5shekel/diffpair/design/references/VL813_GoodYuHuang_schematic.txt

PAGE 1
1
1
2
2
3
3
4
4
5
5
6
6
7
7
8
8
D
D
C
C
B
B
A
A
Title
Number
Revision
Size
A3
Date:
2023/8/27
Sheet            of
File:
C:\Users\..\USB_HUB_VL813.SchDoc
Drawn By:
VBUS
1
D-
2
D+
3
GND
4
Stda_SSRX-
5
Stda_SSRX+
6
GND_DRAIN
7
Stda_SSTX-
8
Stda_SSTX+
9
GND
10
GND
11
J2
TYPE-A3.0
GND
A1
SSTXP1
A2
SSTXN1
A3
VBUS
A4
CC1
A5
DP1
A6
DN1
A7
SBU1
A8
VBUS
A9
SSRXN2
A10
SSRXP2
A11
GND
A12
GND
B1
SSTXP2
B2
SSTXN2
B3
VBUS
B4
CC2
B5
DP2
B6
DN2
B7
SBU2
B8
VBUS
B9
SSRXN1
B10
SSRXP1
B11
GND
B12
1
2
4
3
U1
TYPE-C-24P
GND
GND
GND
GND
CC2
CC1
CC1
R15 10KΩ
R16 10KΩ
R13
10KΩ
GND
GND
GND
R11
20.5KΩ
GND
CC2
R14 10KΩ
4
2
1
3
X1
XTAL_3225_25M
C11
22pF
GND
GND
VBUS
1
D-
2
D+
3
GND
4
Stda_SSRX-
5
Stda_SSRX+
6
GND_DRAIN
7
Stda_SSTX-
8
Stda_SSTX+
9
GND
10
GND
11
J3
TYPE-A3.0
GND
GND
GND
VBUS
1
D-
2
D+
3
GND
4
Stda_SSRX-
5
Stda_SSRX+
6
GND_DRAIN
7
Stda_SSTX-
8
Stda_SSTX+
9
GND
10
GND
11
J4
TYPE-A3.0
GND
GND
GND
VBUS
1
D-
2
D+
3
GND
4
Stda_SSRX-
5
Stda_SSRX+
6
GND_DRAIN
7
Stda_SSTX-
8
Stda_SSTX+
9
GND
10
GND
11
J5
TYPE-A3.0
GND
GND
GND
GND
VBUS
VBUS
H_TX1_N
H_TX1_P
H_RX2_P
H_RX2_N
H_TX2_P
H_TX2_N
H_RX1_N
H_RX1_P
H_TX1_N
H_TX1_P
VCC
8
/HOLD or /RESET(IO3)
7
CLK
6
DI(IO0)
5
GND
4
/WP(IO2)
3
DO(IO1)
2
/CS
1
U6
W25Q16JVSIQ
SPISCLK
3V3
3V3
GND
3V3
1V2
C15
1uF
C22
0.1uF
C25
0.1uF
C28
0.1uF
C30
0.1uF
C32
0.1uF
GND
GND
C17
0.1uF
C27
0.1uF
C29
0.1uF
C31
0.1uF
C33
0.1uF
C34
0.1uF
GND
5V0
GND
H_TX2_N
H_TX2_P
H_RX1_N
H_RX1_P
H_RX2_P
H_RX2_N
TYPE-C 输入
TYPE-C正反插转换
滤波电路
FLASH
USB-A 3.0 接口
电源切换
模式切换
主控 VL813
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
PIU2066 
N
L
 
PIC3502 
PIJ308 
N
L
 
PIC1402 
PIJ309 
N
L
 
PIC3701 
PIU204 
N
L
 
PIC3601 
PIU203 
N
L
 
PIC3702 
PIJ408 
N
L
 
PIC3602 
PIJ409 
N
L
 
PIC3901 
PIU2012 
N
L
 
PIC3801 
PIU2011 
N
L
 
PIC3902 
PIJ508 
N
L
 
PIC3802 
PIJ509 
N
L
 
PIU10A7 
PIU10B7 
PIU2029 
N
L
 
PIU10A6 
PIU10B6 
PIU2028 
N
L
 
PIJ202 
PIU2065 
N
L
 
PIJ203 
PIU2064 
N
L
 
PIJ302 
PIU2073 
N
L
 
PIJ303 
PIU2072 
N
L
 
PIJ402 
PIU2010 
N
L
 
PIJ403 
PIU209 
N
L
 
PIJ502 
PIU2017 
N
L
 
PIJ503 
PIU2016 
N
L
 
PIR2602 
PIU10A4 
PIU10A9 
PIU10B4 
PIU10B9 
PIU305 
PIR102 
PIR201 
PIU2031 
N
L
 
PIC1601 
PIC1801 
PIC1901 
PIC2601 
PIC4001 
PIC4101 
PIR101 
PIR1401 
PIR1501 
PIR1601 
PIR2901 
PIR3001 
PIR3101 
PIR3201 
PIU2019 
PIU2038 
PIU301 
PIU4026 
PIU4027 
PIU501 
PIU704 
PIU705 
PIU804 
PIU805 
PIU904 
PIU905 
PIU1004 
PIU1005 
N
L
