5shekel/diffpair/kicad/usb3_sfp_hub/validation/sfp_filter/nominal_typical_load_step.csv

time_s | module_voltage_V | damping_power_W
0.000000000000000000e+00 | 3.300000000000000711e+00 | 0.000000000000000000e+00
1.000000000000000062e-09 | 3.300000000000063771e+00 | 8.678616557584067457e-26
2.000000000000000125e-09 | 3.300000000000125056e+00 | 1.474477346270917864e-25
4.000000000000000249e-09 | 3.300000000000244516e+00 | 3.129191063782389850e-25
8.000000000000000498e-09 | 3.300000000000307576e+00 | 1.490121558757597380e-25
1.600000000000000100e-08 | 3.300000000000163247e+00 | 5.055314210295395587e-26
3.200000000000000199e-08 | 3.300000000000103295e+00 | 2.752986967202978712e-26
6.400000000000000399e-08 | 3.300000000000079758e+00 | 1.436873447655179083e-26
1.280000000000000080e-07 | 3.299999999999950084e+00 | 5.349577673545279807e-27
2.280000000000000034e-07 | 3.299999999999964739e+00 | 1.490121558757597308e-27
3.279999999999999725e-07 | 3.300000000000048672e+00 | 6.826398670528801891e-27
4.279999999999999679e-07 | 3.300000000000043787e+00 | 5.549544740217583250e-27
5.279999999999999634e-07 | 3.300000000000043787e+00 | 5.449102566820256446e-27
6.279999999999999589e-07 | 3.300000000000043787e+00 | 5.449102566820256446e-27
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
