5shekel/diffpair/kicad/usb3_sfp_hub/validation/sfp_filter/sensitivity_high_C_low_L_load_step.csv

time_s | module_voltage_V | damping_power_W
0.000000000000000000e+00 | 3.300000000000001599e+00 | 0.000000000000000000e+00
1.000000000000000062e-09 | 3.299999999999927880e+00 | 2.872337619486020728e-26
2.000000000000000125e-09 | 3.299999999999855937e+00 | 7.749673542769326604e-26
4.000000000000000249e-09 | 3.299999999999714717e+00 | 2.421661217555052156e-25
8.000000000000000498e-09 | 3.299999999999597033e+00 | 3.744175313956583345e-25
1.600000000000000100e-08 | 3.299999999999706279e+00 | 1.933311472417264518e-25
3.200000000000000199e-08 | 3.299999999999763123e+00 | 1.386153879435481223e-25
6.400000000000000399e-08 | 3.299999999999716049e+00 | 1.862152772016778504e-25
1.280000000000000080e-07 | 3.300000000000003819e+00 | 7.829310135209714074e-29
2.280000000000000034e-07 | 3.300000000000038902e+00 | 3.669583762189120813e-27
3.279999999999999725e-07 | 3.299999999999969624e+00 | 1.838729699801618597e-27
4.279999999999999679e-07 | 3.299999999999974953e+00 | 1.204972524359790934e-27
5.279999999999999634e-07 | 3.299999999999974953e+00 | 1.158181972664158765e-27
6.279999999999999589e-07 | 3.299999999999974953e+00 | 1.067380506007288771e-27
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
