5shekel/diffpair/kicad/usb3_sfp_hub/validation/sfp_filter/sensitivity_low_C_high_L_load_step.csv

time_s | module_voltage_V | damping_power_W
0.000000000000000000e+00 | 3.299999999999998934e+00 | 0.000000000000000000e+00
1.000000000000000062e-09 | 3.299999999999949640e+00 | 1.129118910605808186e-25
2.000000000000000125e-09 | 3.299999999999966960e+00 | 1.695204226112236907e-27
4.000000000000000249e-09 | 3.300000000000001599e+00 | 7.918597056210023119e-27
8.000000000000000498e-09 | 3.300000000000014033e+00 | 1.238769165231340643e-27
1.600000000000000100e-08 | 3.299999999999954525e+00 | 8.767522169442607962e-27
3.200000000000000199e-08 | 3.299999999999884803e+00 | 3.811828108434893557e-26
6.400000000000000399e-08 | 3.299999999999839506e+00 | 5.433164824694425165e-26
1.280000000000000080e-07 | 3.299999999999949640e+00 | 4.149369553457345614e-27
2.280000000000000034e-07 | 3.300000000000023803e+00 | 1.016064135526169104e-27
3.279999999999999725e-07 | 3.299999999999991385e+00 | 1.592010212347860374e-28
4.279999999999999679e-07 | 3.299999999999992273e+00 | 1.274490169995932529e-28
5.279999999999999634e-07 | 3.299999999999992717e+00 | 1.128960150584632388e-28
6.279999999999999589e-07 | 3.299999999999992273e+00 | 1.274490169995932529e-28
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
