5shekel/diffpair/design/references/murata_cap_characteristics.csv

#GRM32ER71E226KE15 |  |  | #GRM32ER71E226KE15 |  | #GRM32ER71E226KE15
#2026/09/12 |  |  | #2026/09/12 |  | #2026/09/12
#c_dcbias_capchange_cap |  |  | #r |  | #z
#capchange 25.0degC AC0.5Vrms |  |  | #DC3.3V 25degC |  | #DC3.3V 25degC
DC Bias[V] | Cap. Change Rate[%] | Cap. Change Rate[%] | Frequency[Hz] | Resistance[ohm] | Frequency[Hz] | Impedance[ohm]
0.0 | 0.0 | 23.830333333333332 | 99.99999999999999 | 2.193693341974461 | 99.99999999999999 | 97.12441311978368
0.125 | 0.58022516747116 | 23.9686029248256 | 104.57921513303334 | 2.1014323606420886 | 104.57921513303334 | 92.9242904145339
0.25 | 1.1086493770712913 | 24.094528175387346 | 109.3681223784127 | 2.0143523428409655 | 109.3681223784127 | 88.90613466545932
0.375 | 1.580166881581202 | 24.20689236843707 | 114.37632398907938 | 1.9320639413324068 | 114.37632398907938 | 85.06221490795757
0.5 | 1.990530946874336 | 24.30468349307664 | 119.61386192579457 | 1.8541903111491207 | 119.61386192579457 | 81.38510577590293
0.625 | 2.336298974953399 | 24.387081166727977 | 125.09123799230618 | 1.7803696265213147 | 125.09123799230618 | 77.86767566469749
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
