5shekel/diffpair/kicad/usb3_sfp_hub/validation/sfp_filter_comparison/corners/L011_2C_R068/worst_minimum_waveform.csv

time_s | rail_at_low_source_V | rail_at_high_source_V
0.000000000000000000e+00 | 3.208750000000000657e+00 | 3.391250000000000764e+00
5.000000000000000311e-10 | 3.208749999999985114e+00 | 3.391249999999985221e+00
1.000000000000000062e-09 | 3.208749999999970459e+00 | 3.391249999999970566e+00
2.000000000000000125e-09 | 3.208749999999942926e+00 | 3.391249999999943032e+00
4.000000000000000249e-09 | 3.208749999999842561e+00 | 3.391249999999842668e+00
8.000000000000000498e-09 | 3.208749999999789271e+00 | 3.391249999999789377e+00
1.600000000000000100e-08 | 3.208750000000005986e+00 | 3.391250000000006093e+00
3.200000000000000199e-08 | 3.208750000000047731e+00 | 3.391250000000047837e+00
6.400000000000000399e-08 | 3.208749999999989111e+00 | 3.391249999999989218e+00
1.140000000000000017e-07 | 3.208749999999983338e+00 | 3.391249999999983444e+00
1.639999999999999862e-07 | 3.208750000000018421e+00 | 3.391250000000018527e+00
2.139999999999999840e-07 | 3.208750000000001101e+00 | 3.391250000000001208e+00
2.639999999999999817e-07 | 3.208750000000008651e+00 | 3.391250000000008757e+00
3.139999999999999794e-07 | 3.208750000000005542e+00 | 3.391250000000005649e+00
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
