5shekel/diffpair/kicad/usb3_sfp_hub/validation/sfp_filter_comparison/corners/L011_2C_R068/worst_peak_ac.csv

frequency_Hz | voltage_gain_dB
1.000000000000000000e+02 | 1.000322623270088299e-05
1.015468992433080189e+02 | 1.031509944976251403e-05
1.031177274593055131e+02 | 1.063669601735792775e-05
1.047128548050899326e+02 | 1.096831908193533164e-05
1.063326571637160924e+02 | 1.131028124218813140e-05
1.079775162327709239e+02 | 1.166290484220460267e-05
1.096478196143184505e+02 | 1.202652227618914064e-05
1.113439609062360915e+02 | 1.240147629896907004e-05
1.130663397949638380e+02 | 1.278812035771622698e-05
1.148153621496882124e+02 | 1.318681891402486412e-05
1.165914401179830975e+02 | 1.359794779106153113e-05
1.183949922229300995e+02 | 1.402189453421508647e-05
1.202264434617411979e+02 | 1.445905876788884187e-05
1.220862254059070153e+02 | 1.490985257736464471e-05
1.239747763028943126e+02 | 1.537470089452367601e-05
1.258925411794165967e+02 | 1.585404189899584002e-05
1.278399719463022279e+02 | 1.634832743280903612e-05
1.298175275049847528e+02 | 1.685802342468099803e-05
1.318256738556405310e+02 | 1.738361032973958383e-05
1.338648842069991360e+02 | 1.792558358081417156e-05
1.359356390878523655e+02 | 1.848445405901272764e-05
1.380384264602882638e+02 | 1.906074857394120714e-05
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
