5shekel/diffpair/kicad/usb3_sfp_hub/validation/sfp_filter_comparison/corners/L011_2C_R100/worst_minimum_waveform.csv

time_s | rail_at_low_source_V | rail_at_high_source_V
0.000000000000000000e+00 | 3.208750000000000657e+00 | 3.391250000000000764e+00
5.000000000000000311e-10 | 3.208749999999992664e+00 | 3.391249999999992770e+00
1.000000000000000062e-09 | 3.208749999999985114e+00 | 3.391249999999985221e+00
2.000000000000000125e-09 | 3.208749999999970903e+00 | 3.391249999999971010e+00
4.000000000000000249e-09 | 3.208749999999994440e+00 | 3.391249999999994547e+00
8.000000000000000498e-09 | 3.208750000000144542e+00 | 3.391250000000144649e+00
1.600000000000000100e-08 | 3.208750000000257341e+00 | 3.391250000000257447e+00
3.200000000000000199e-08 | 3.208750000000002878e+00 | 3.391250000000002984e+00
6.400000000000000399e-08 | 3.208749999999860325e+00 | 3.391249999999860432e+00
1.140000000000000017e-07 | 3.208750000000081926e+00 | 3.391250000000082032e+00
1.639999999999999862e-07 | 3.208750000000000657e+00 | 3.391250000000000764e+00
2.139999999999999840e-07 | 3.208750000000026859e+00 | 3.391250000000026965e+00
2.639999999999999817e-07 | 3.208750000000017089e+00 | 3.391250000000017195e+00
3.139999999999999794e-07 | 3.208750000000019753e+00 | 3.391250000000019860e+00
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
