5shekel/diffpair/kicad/usb3_sfp_hub/validation/sfp_filter_comparison/corners/L011_2C_R100/worst_peak_ac.csv

frequency_Hz | voltage_gain_dB
1.000000000000000000e+02 | 1.000321585269198834e-05
1.015468992433080189e+02 | 1.031508841594074586e-05
1.031177274593055131e+02 | 1.063668428536433662e-05
1.047128548050899326e+02 | 1.096830660933962996e-05
1.063326571637160924e+02 | 1.131026798077407826e-05
1.079775162327709239e+02 | 1.166289074375597241e-05
1.096478196143184505e+02 | 1.202650728477510262e-05
1.113439609062360915e+02 | 1.240146036251611049e-05
1.130663397949638380e+02 | 1.278810341257893399e-05
1.148153621496882124e+02 | 1.318680089848648255e-05
1.165914401179830975e+02 | 1.359792863761937451e-05
1.183949922229300995e+02 | 1.402187416958052351e-05
1.202264434617411979e+02 | 1.445903711684460486e-05
1.220862254059070153e+02 | 1.490982955697887958e-05
1.239747763028943126e+02 | 1.537467641993589735e-05
1.258925411794165967e+02 | 1.585401587570232779e-05
1.278399719463022279e+02 | 1.634829976437744066e-05
1.298175275049847528e+02 | 1.685799400696439684e-05
1.318256738556405310e+02 | 1.738357905087647827e-05
1.338648842069991360e+02 | 1.792555032508579349e-05
1.359356390878523655e+02 | 1.848441870105708279e-05
1.380384264602882638e+02 | 1.906071097875309880e-05
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
