5shekel/diffpair/kicad/usb3_sfp_hub/validation/sfp_filter_comparison/corners/L047_4C_R068/worst_minimum_waveform.csv

time_s | rail_at_low_source_V | rail_at_high_source_V
0.000000000000000000e+00 | 3.208750000000001101e+00 | 3.391250000000001208e+00
5.000000000000000311e-10 | 3.208749999999991775e+00 | 3.391249999999991882e+00
1.000000000000000062e-09 | 3.208749999999983338e+00 | 3.391249999999983444e+00
2.000000000000000125e-09 | 3.208749999999966906e+00 | 3.391249999999967013e+00
4.000000000000000249e-09 | 3.208749999999789271e+00 | 3.391249999999789377e+00
8.000000000000000498e-09 | 3.208749999999504166e+00 | 3.391249999999504272e+00
1.600000000000000100e-08 | 3.208749999999813252e+00 | 3.391249999999813358e+00
3.200000000000000199e-08 | 3.208750000000090363e+00 | 3.391250000000090470e+00
6.400000000000000399e-08 | 3.208749999999973568e+00 | 3.391249999999973674e+00
1.140000000000000017e-07 | 3.208750000000117897e+00 | 3.391250000000118003e+00
1.639999999999999862e-07 | 3.208749999999948699e+00 | 3.391249999999948805e+00
2.139999999999999840e-07 | 3.208749999999986890e+00 | 3.391249999999986997e+00
2.639999999999999817e-07 | 3.208749999999967795e+00 | 3.391249999999967901e+00
3.139999999999999794e-07 | 3.208749999999977565e+00 | 3.391249999999977671e+00
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
