5shekel/diffpair/kicad/usb3_sfp_hub/validation/sfp_filter_comparison/corners/L047_4C_R068/worst_peak_ac.csv

frequency_Hz | voltage_gain_dB
1.000000000000000000e+02 | 8.528886006967064846e-05
1.015468992433080189e+02 | 8.794793790859489519e-05
1.031177274593055131e+02 | 9.068991877984033392e-05
1.047128548050899326e+02 | 9.351738738547851900e-05
1.063326571637160924e+02 | 9.643300901547897258e-05
1.079775162327709239e+02 | 9.943953206032004504e-05
1.096478196143184505e+02 | 1.025397905910758702e-04
1.113439609062360915e+02 | 1.057367070474789607e-04
1.130663397949638380e+02 | 1.090332949780263507e-04
1.148153621496882124e+02 | 1.124326618899861762e-04
1.165914401179830975e+02 | 1.159380121726589585e-04
1.183949922229300995e+02 | 1.195526501208920943e-04
1.202264434617411979e+02 | 1.232799830569165337e-04
1.220862254059070153e+02 | 1.271235245254312635e-04
1.239747763028943126e+02 | 1.310868976236490599e-04
1.258925411794165967e+02 | 1.351738384026558281e-04
1.278399719463022279e+02 | 1.393881993998683628e-04
1.298175275049847528e+02 | 1.437339532640146550e-04
1.318256738556405310e+02 | 1.482151965054202152e-04
1.338648842069991360e+02 | 1.528361533503819246e-04
1.359356390878523655e+02 | 1.576011797304835860e-04
1.380384264602882638e+02 | 1.625147673837060278e-04
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
