5shekel/diffpair/TODO.md

# 🪄 AI Console — issues & TODO (WIP)

Status legend: [ ] open · [x] done

## Findings (from log + code audit, 2026-08-25)

### Process / runtime
1. **Stale running process** — watchdog PID 3413026 booted Aug 23 20:44 but
   `watchdog.js` on disk was edited Aug 23 22:39. The running code ≠ disk code;
   the Aug 23 edit never went live. Same for the gate (PID 929497 booted
   Aug 24 00:32, `gate.js` edited 22:42).
2. **Failed restart crashed with a raw stack trace** — `watchdog.log` ends in
   `EADDRINUSE :::8737` (Aug 24 22:33). No friendly "already running" message,
   no single-instance guard.
3. **Watchdog bound to `*` (all interfaces)** — `server.listen(PORT)` has no
   host, so `:8737` was reachable from the LAN, bypassing the gate's
   whitelist entirely.
4. **Dead zrok share on :8091** (PID 931955) — nothing listens on 8091, the
   tunnel just 502s.
5. **`agent.log` grew to 19 MB** — zrok logs every access; a panel left open on
   the public URL polled `/api/status` ~68,000 times. No rotation.

### Duplicate commits (the reported bug)
6. **`/api/restore` and `/api/revert` commit unconditionally** — every restore
   call pushes a new manifest entry even when the content is byte-identical to
   the last commit. Manifest already has hash `2769d1e5` 4× (all
   "restored last-known-good").
7. **Revert path commits with the wrong note** — it says
   "restored last-known-good" instead of which commit was reverted.
8. **Restore doesn't update `lastGoodSize`** — after restoring a smaller
   known-good, the next healthy change can be falsely flagged "ballooned 4×".
9. **Boot path can also add a duplicate** — "uncommitted change found at boot"
   has no hash-dedupe (it does compare, but restore/initial flows compound).
10. **Dead code in `commit()`** — `note === "restored"` never matches (the
    actual note is "restored last-known-good").

### Status / health reporting
11. **`/api/status` always reports `healthy: true`** — even right after a
    breakage; a reconnecting panel gets "✅" for a broken page.
12. **Panel `status` SSE handler unconditionally shows ✅** — ignores
    `s.healthy`, same problem client-side.

### Security (public tunnel `diffpair.z.idiot.io`)
13. **Gate allows state-changing POSTs publicly** — anyone on the internet can
    `POST /api/restore` / `/api/revert` (overwrite the file) or spam
    `/api/instruction`. No auth of any kind.

### Robustness
14. **SSE responses have no `error` handler** — a dying client can raise an
    unhandled 'error' on `res.write` and crash the server. [x] fixed.
15. **Watcher re-hashes on *any* file change in the project root** — log
    writes (agent.log, instructions.log, photos) trigger a 2 MB read + sha256.
    Wasteful, not wrong. [x] fixed — see "T15-watcher" below (this finding
    was never actually given a task number; T15 in the Tasks list below is a
    different, still-open item — the instruction ack queue).

### Housekeeping
16. **`webroot/` is a dead design** — duplicate copies of the HTML, a dead
    `python http.server` (see `webroot-server.log` 404s on `/api/status`), and
    `gate.js`. The running watchdog still uses `ROOT = __dirname`.
17. **No instruction ack/queue** — instructions sit in `instructions.log` with
    no record of which were acted on; if no agent is watching the terminal
    they're silently lost (this is exactly what happened to the 2026-08-25
    instruction).

## Tasks

- [x] T1: Dedupe commits — skip commit when `sha8(buf)` == last manifest hash
      (restore, revert, watcher, boot paths)
- [x] T2: Fix revert note → "reverted to <id>"
- [x] T3: Update `lastGoodSize` on restore
- [x] T4: Track real health in `/api/status` (+ breakage detail for reconnects)
- [x] T5: Panel: respect `s.healthy` in the status SSE handler
- [x] T6: Bind watchdog to 127.0.0.1
- [x] T7: Friendly single-instance error on EADDRINUSE
- [x] T8: Gate: block `/api/restore` + `/api/revert` publicly (keep
      `/api/instruction` so remote suggestions still work — add real auth later)
- [x] T9: SSE res error handler
- [x] T10: Clean up duplicate manifest entries + orphan .versions files
- [x] T11: Kill dead zrok share (:8091), truncate agent.log
- [x] T12: Restart watchdog + gate with the new code, verify
      (restore twice → no new commit; restore blocked publicly; port local-only)
- [x] T13b (bonus, not originally numbered): fixed a debounce/restore race in
      `onDirEvent` — the 700ms-delayed health check re-reads the file at fire
      time instead of trusting a stale buffer, so a restore that lands while
      a breakage check is still pending can no longer get silently
      overwritten back to "unhealthy" with stale data.

- [x] T13: Decide the fate of `webroot/` — deleted the dead duplicate
      `webroot/diffpair-mapper.html` and `webroot/index.html` (both were
      untracked in git, byte-identical to the real files, and unused —
      `gate.js` only proxies, it never serves them). Kept `webroot/gate.js`,
      the actively-run public gate.
- [ ] T15: Instruction queue with ack state (e.g. instructions.json with
      status: pending/done) so agents can't silently miss instructions.
      Not done — needs a decision on who/what consumes the ack state.
- [x] T16: Log rotation for agent.log — the previous truncate had gone stale
      (zrok's writer held a stale fd offset, so the "0-byte" file was
      actually sparse and would have kept *looking* huge). Restarted the
      zrok agent + share cleanly instead so the log genuinely starts at 0;
      combined with T17's slower poll this should stay small. No real
      rotation mechanism exists yet if it grows again.
- [x] T17: Panel: SSE-only once the `/api/events` connection is confirmed
      live (`open` event), falling back to polling otherwise; bumped the
      fallback poll from 4s → 15s since SSE never connects over the public
      zrok tunnel (documented buffering caveat in SHARE.md), so public
      viewers poll indefinitely — 15s keeps that from generating another
      68k-hit log.
- [x] T15-watcher (finding #15, not the instruction-queue T15 above):
      `fs.watch(ROOT, ...)` now filters on `filename` and only reacts to
      `diffpair-mapper.html` — writes to `agent.log`, `instructions.log`,
      `photos/`, etc. no longer trigger a 2 MB read + sha256.
- [x] T18 (new, from "how do we monitor AI edits to watchdog.js itself?"):
      control-plane drift detection. The watcher fix above means the
      watchdog now ignores *everything* except its own target file — so an
      edit to `watchdog.js`/`gate.js` (by an AI agent or anyone else) would
      otherwise go completely unnoticed by the running process. Added a
      boot-time hash of both files + a drift check (instant via the fs
      watcher for `watchdog.js`, every 20s for `gate.js` since it's in a
      subdirectory the non-recursive watcher can't see into). On drift:
      logs loudly, sets `controlPlane.{watchdogChanged,gateChanged}` in
      `/api/status`, and emits a `control-drift` SSE event — but never
      auto-applies or auto-restarts. This is detection only, not
      prevention: nothing stops filesystem-write access (including an AI
      coding session) from editing these files directly; see AI-CONSOLE.md
      "Watching the watchdog" for the caveat. Real prevention would need
      OS-level permissions or a separate trust boundary — not done.

## 2026-08-25 (later) — agent.log pollution, round 2

19. **`agent.log` grew again (271 KB and climbing, ~1 req/sec)** — not the
    same cause as finding #5. Root cause: a handful of already-open browser
    tabs on `diffpair.z.idiot.io` (all from IP `37.142.148.130`) are still
    running the *pre-T17* inline JS, which polled `/api/status` every 4s
    instead of 15s. The currently-served page already polls at 15s (T17)
    — this is stale code sitting in tabs that loaded before that fix
    shipped, not a regression. Confirmed by grepping `.versions/` for the
    literal `4000)` interval: present in the snapshot from 15:15 UTC,
    absent from the current file.
    - [x] Immediate: reset `agent.log`. Naive truncate doesn't work here —
      zrok's writer doesn't reopen on truncate, so the fd's internal write
      offset stays put and you get a sparse file that *looks* huge again
      (this is the same failure mode T16 already diagnosed). Real fix is a
      clean restart: killed `zrok2 share` + `zrok2 agent`, found the
      backend still had the old share token registered (`zrok2 overview`
      showed `iein0x6pk2fz` still bound to `diffpair.z.idiot.io` after the
      local process died — restarting `zrok2 agent` alone hit `409
      shareConflict` trying to auto-rejoin it), cleared it with
      `zrok2 delete share <token>`, then re-shared clean. Verified: gate
      (8090), watchdog (8737), and the public URL all return 200 on
      `/api/status` afterward, `agent.log` back to ~11 KB of boot-only
      lines.
    - [x] Forward fix: the poller-only path (what public/SSE-less tabs run
      forever) never checked whether the page it loaded is still current —
      `showReload()` was only ever called from SSE events or a local
      restore/revert. Added `checkDrift()` in `diffpair-mapper.html`: the
      poller now remembers the `lastCommit.hash` from its first
      `/api/status` response and shows the reload banner the moment a
      later poll reports a different hash. This can't retroactively fix
      tabs that were *already* open when this shipped (they're running the
      old JS, which is the whole problem) but it means the *next* time the
      page changes, any tab still open — poller or SSE — finds out instead
      of silently drifting forever.
    - [x] The stale tabs kept polling every 4s post-restart as expected
      (confirmed — nothing server-side reaches an already-loaded page), so
      rather than chase that, silenced the actual symptom at the source:
      `zrok2 agent start`'s stdout is now piped through
      `grep -v '"msg":"map\[method:'` before landing in `agent.log` (see
      SHARE.md's new "agent.log — filtered, on purpose" section). Verified
      3 requests through the public URL landed 200s with zero new
      `msg:access` lines in the file, then watched it 15s with the stale
      tabs still hitting it — flat. `zrok2` has no built-in log-level flag
      for this (`-v` only adds verbosity), so filtering the pipe was the
      only option short of dropping the log entirely.
    - Hit a second, unrelated gotcha along the way: `zrok2 agent` persists
      a local registry (`~/.zrok2/agent-registry.json`) and replays it on
      every boot to auto-recreate shares. Restarting the agent *and* also
      re-running `zrok2 share public ...` (as SHARE.md's old repro steps
      did) races the two and leaves duplicate registry entries that
      permanently 409-conflict with each other. Fixed by hand-editing the
      registry down to one entry; SHARE.md now says to restart the agent
      alone and only fall back to re-sharing if that doesn't bring it back.
