5shekel/diffpair/(list of files, drawings)

Other design files:
design/references/tps62902_models/pspice/TPS62902_PSPICE_TRANS/TPS62902_TRANS.dsn
design/references/tps62902_models/pspice/TPS62902_PSPICE_TRANS/TPS62902_TRANS.opj
design/references/tps62902_models/pspice/TPS62902_PSPICE_TRANS/TPS62902RPJ_TRANS.OLB
