5shekel/diffpair/kicad/usb3_sfp_hub/hub_support.kicad_sch

## KiCad design kicad/usb3_sfp_hub/hub_support.kicad_sch (2026-09-13)

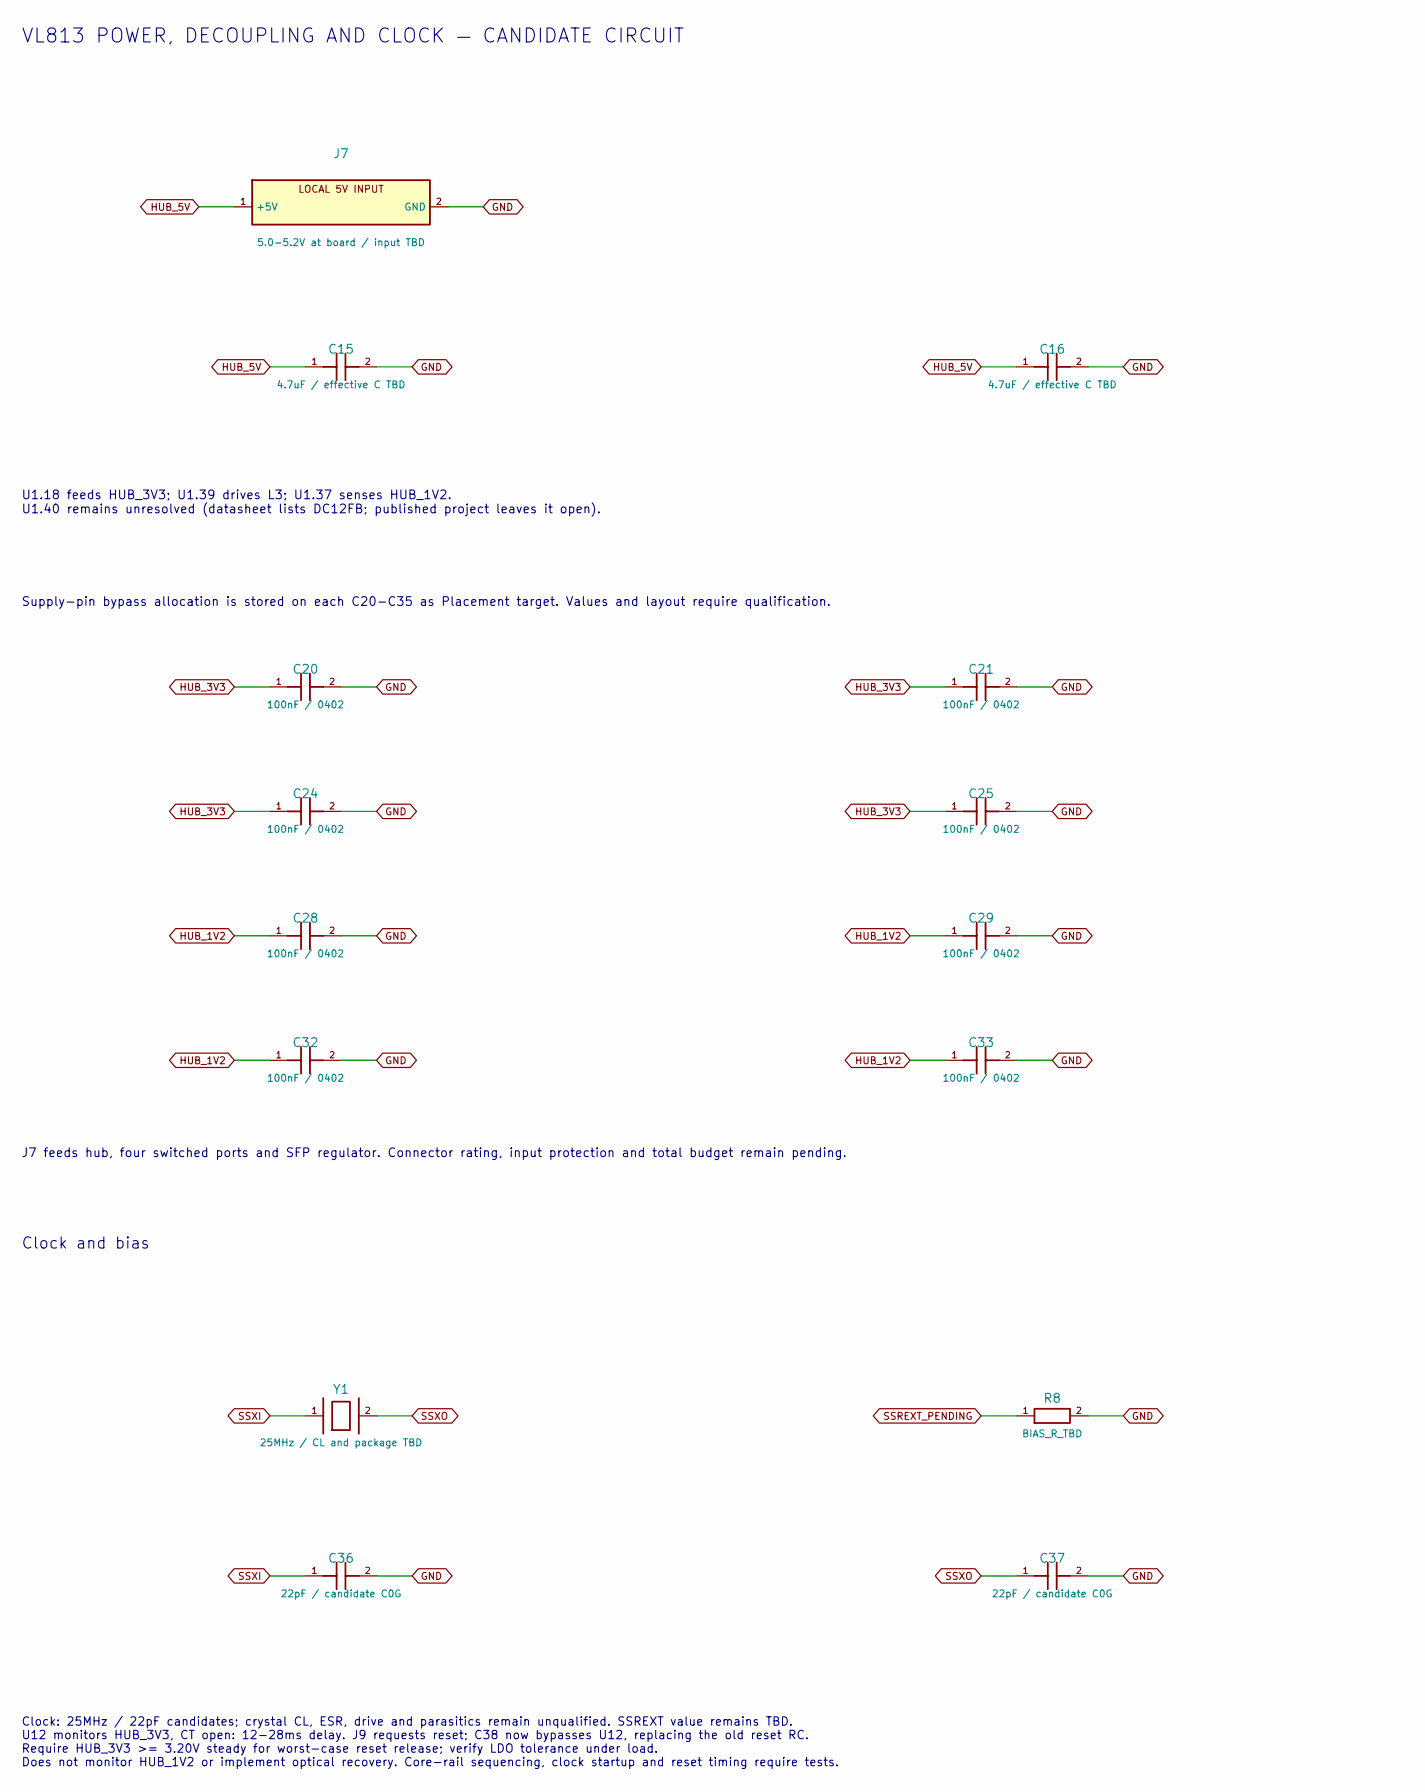
[picture p1: schematic hub_support.kicad_sch, part in row 1, column 1]

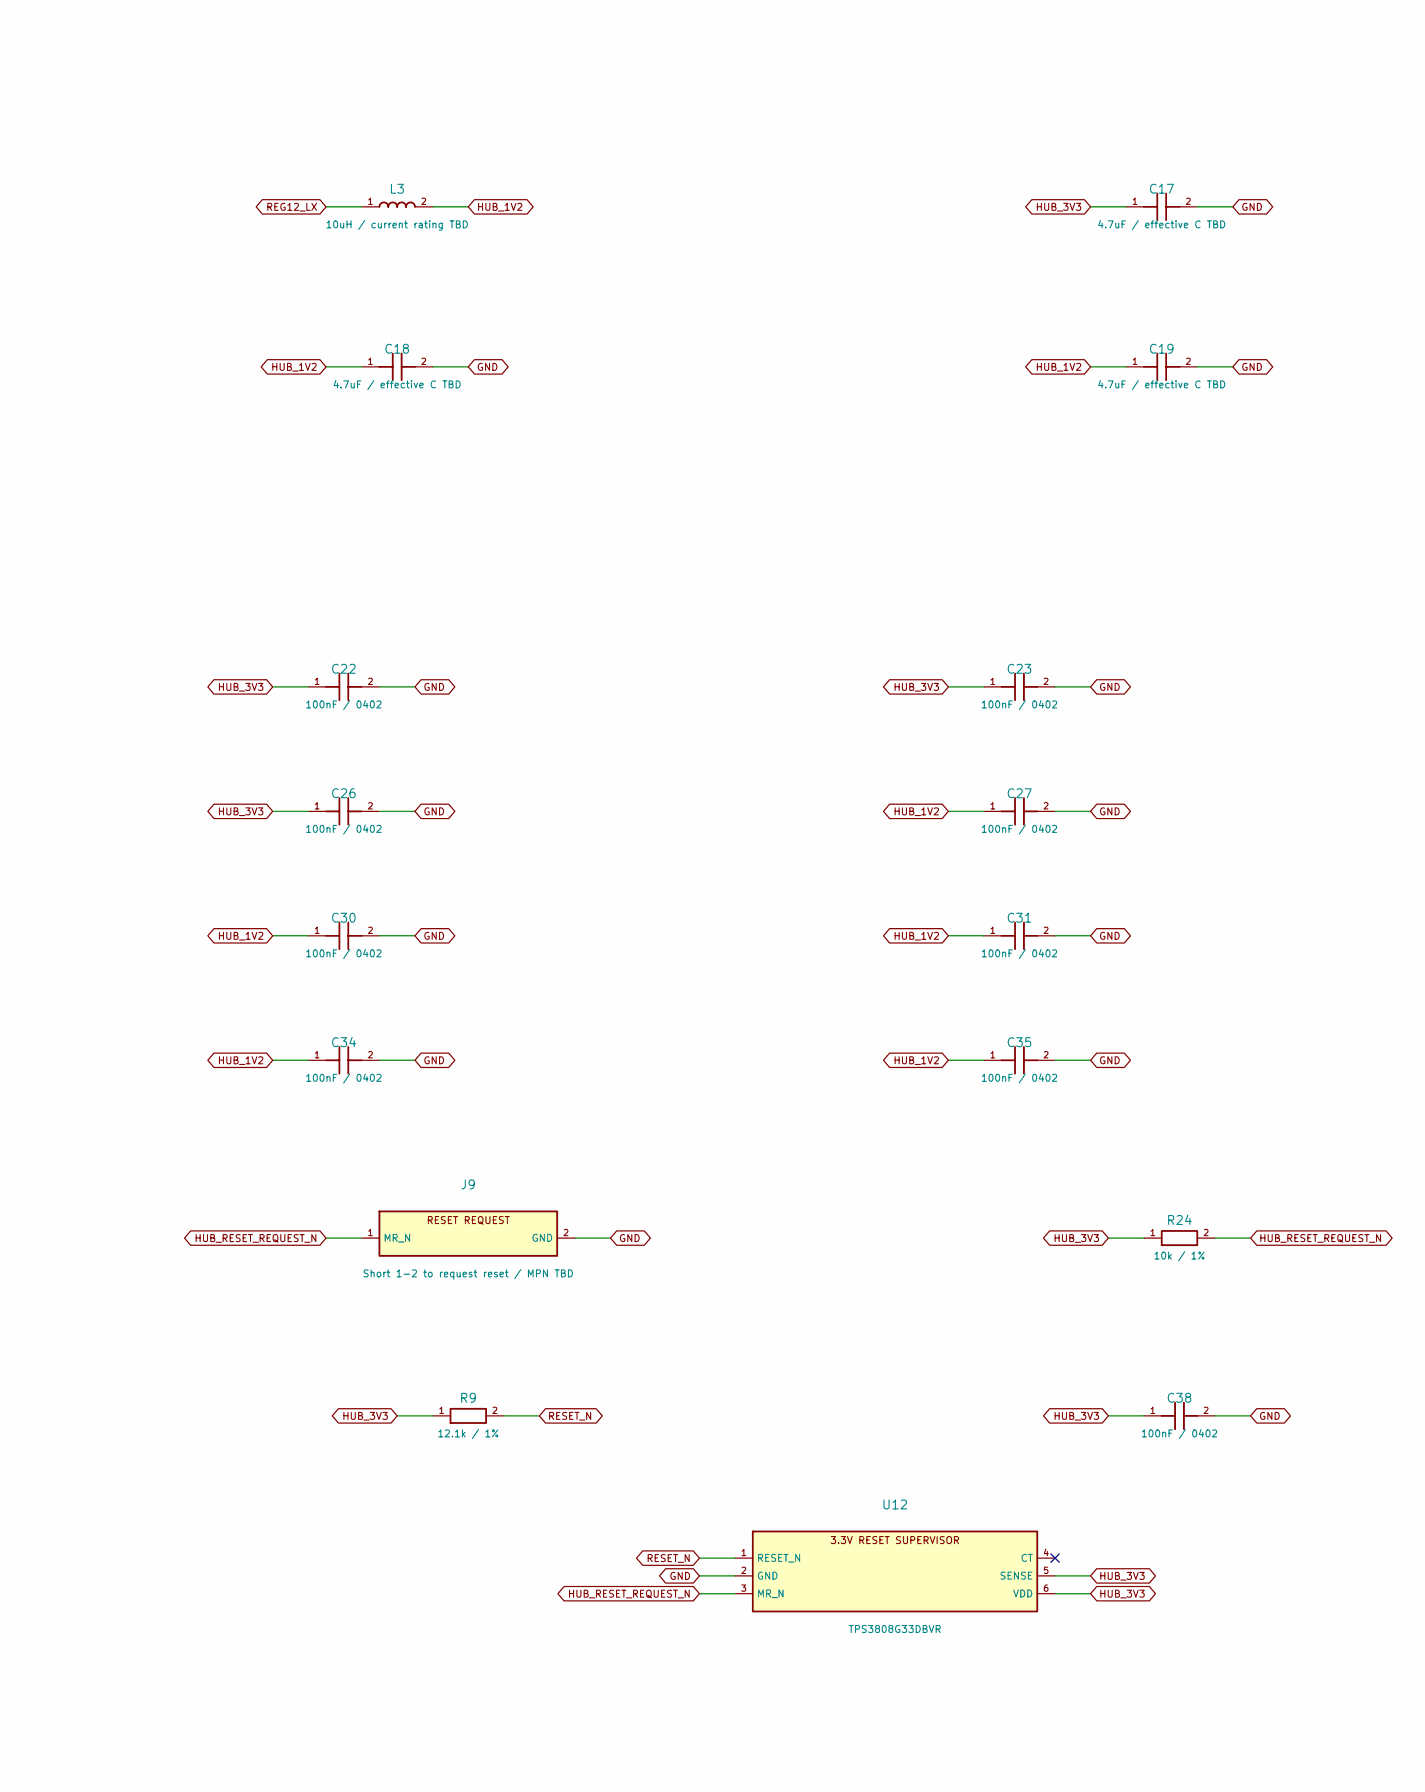
[picture p2: schematic hub_support.kicad_sch, part in row 1, column 2]

Parts:
C15, C16, C17, C18, C19: 4.7uF / effective C TBD
C20, C21, C22, C23, C24, C25, C26, C27, C28, C29, C30, C31, C32, C33, C34, C35, C38: 100nF / 0402; C_0402_1005Metric; MPN CL05B104KO5NNNC; LCSC C1525
C36, C37: 22pF / candidate C0G; C_0402_1005Metric
J7: 5.0-5.2V at board / input TBD
J9: Short 1-2 to request reset / MPN TBD; PinHeader_1x02_P2.54mm_Vertical
L3: 10uH / current rating TBD
R8: BIAS_R_TBD; R_0603_1608Metric
R9: 12.1k / 1%; R_0603_1608Metric; MPN 0603WAF1212T5E; LCSC C22864
R24: 10k / 1%; R_0603_1608Metric; MPN 0603WAF1002T5E; LCSC C25804
U12: TPS3808G33DBVR; SOT-23-6; MPN TPS3808G33DBVR; LCSC C43698
Y1: 25MHz / CL and package TBD

Connections:
GND: C15.2, C16.2, C17.2, C18.2, C19.2, C20.2, C21.2, C22.2, C23.2, C24.2, C25.2, C26.2, C27.2, C28.2, C29.2, C30.2, C31.2, C32.2, C33.2, C34.2, C35.2, C36.2, C37.2, C38.2, J7.2 (GND), J9.2 (GND), R8.2, U12.2 (GND)
HUB_1V2: C18.1, C19.1, C27.1, C28.1, C29.1, C30.1, C31.1, C32.1, C33.1, C34.1, C35.1, L3.2
HUB_3V3: C17.1, C20.1, C21.1, C22.1, C23.1, C24.1, C25.1, C26.1, C38.1, R9.1, R24.1, U12.5 (SENSE), U12.6 (VDD)
HUB_5V: C15.1, C16.1, J7.1 (+5V)
HUB_RESET_REQUEST_N: J9.1 (MR_N), R24.2, U12.3 (MR_N)
REG12_LX: L3.1
RESET_N: R9.2, U12.1 (RESET_N)
SSREXT_PENDING: R8.1
SSXI: C36.1, Y1.1
SSXO: C37.1, Y1.2

Notes on the sheet:
VL813 POWER, DECOUPLING AND CLOCK — CANDIDATE CIRCUIT
U1.18 feeds HUB_3V3; U1.39 drives L3; U1.37 senses HUB_1V2. U1.40 remains unresolved (datasheet lists DC12FB; published project leaves it open).
Supply-pin bypass allocation is stored on each C20-C35 as Placement target. Values and layout require qualification.
Clock and bias
Clock: 25MHz / 22pF candidates; crystal CL, ESR, drive and parasitics remain unqualified. SSREXT value remains TBD. U12 monitors HUB_3V3, CT open: 12-28ms delay. J9 requests reset; C38 now bypasses U12, replacing the old reset RC. Require HUB_3V3 >= 3.20V steady for worst-case reset release; verify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
J7 feeds hub, four switched ports and SFP regulator. Connector rating, input protection and total budget remain pending.
