5shekel/diffpair/kicad/usb3_sfp_hub/port_power.kicad_sch

## KiCad design kicad/usb3_sfp_hub/port_power.kicad_sch (2026-09-13)

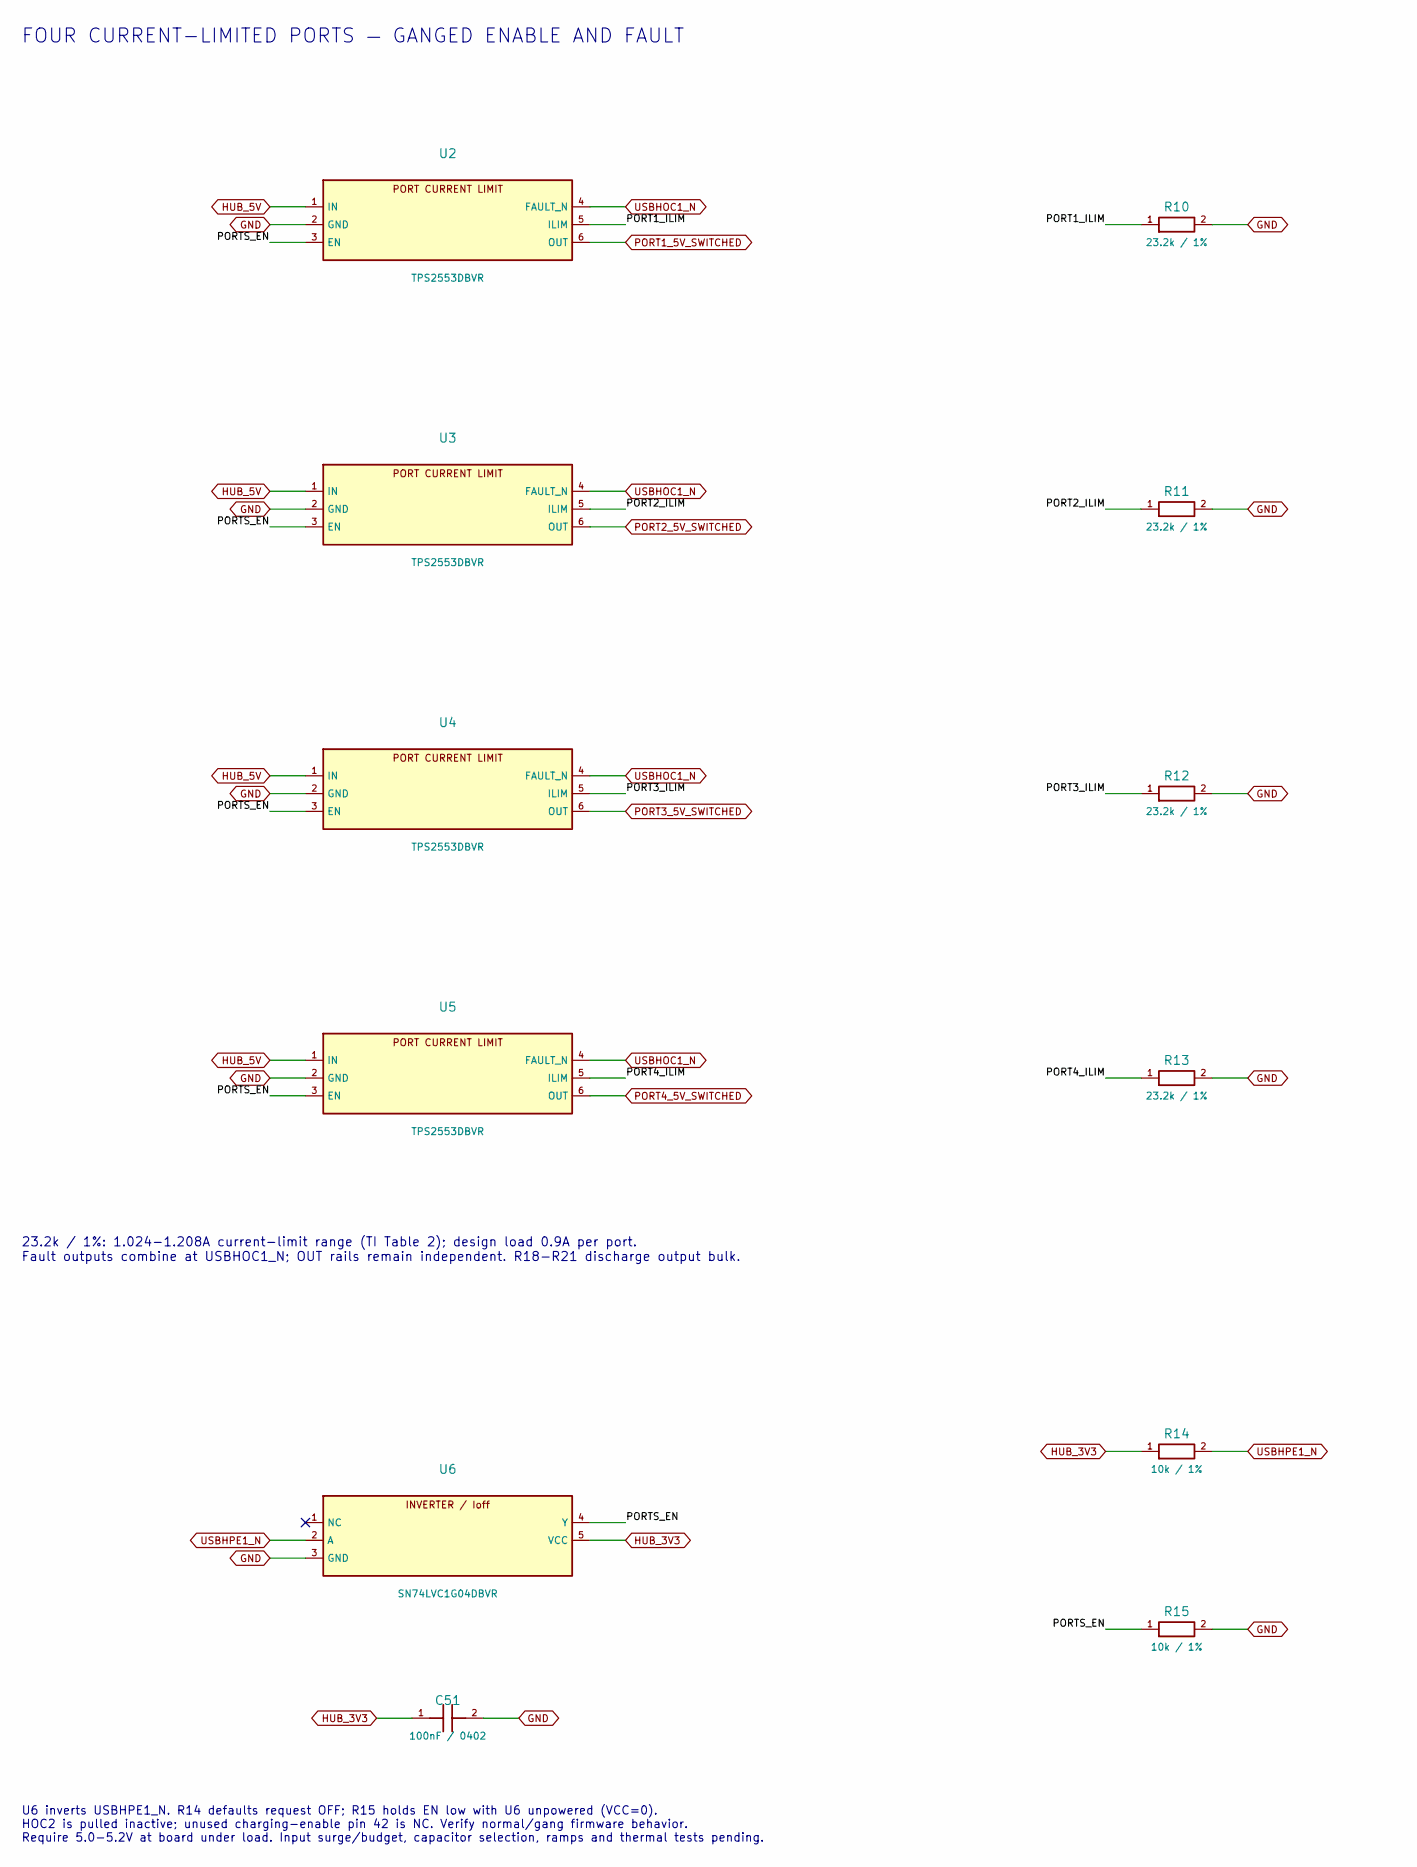
[picture p3: schematic port_power.kicad_sch, part in row 1, column 1]

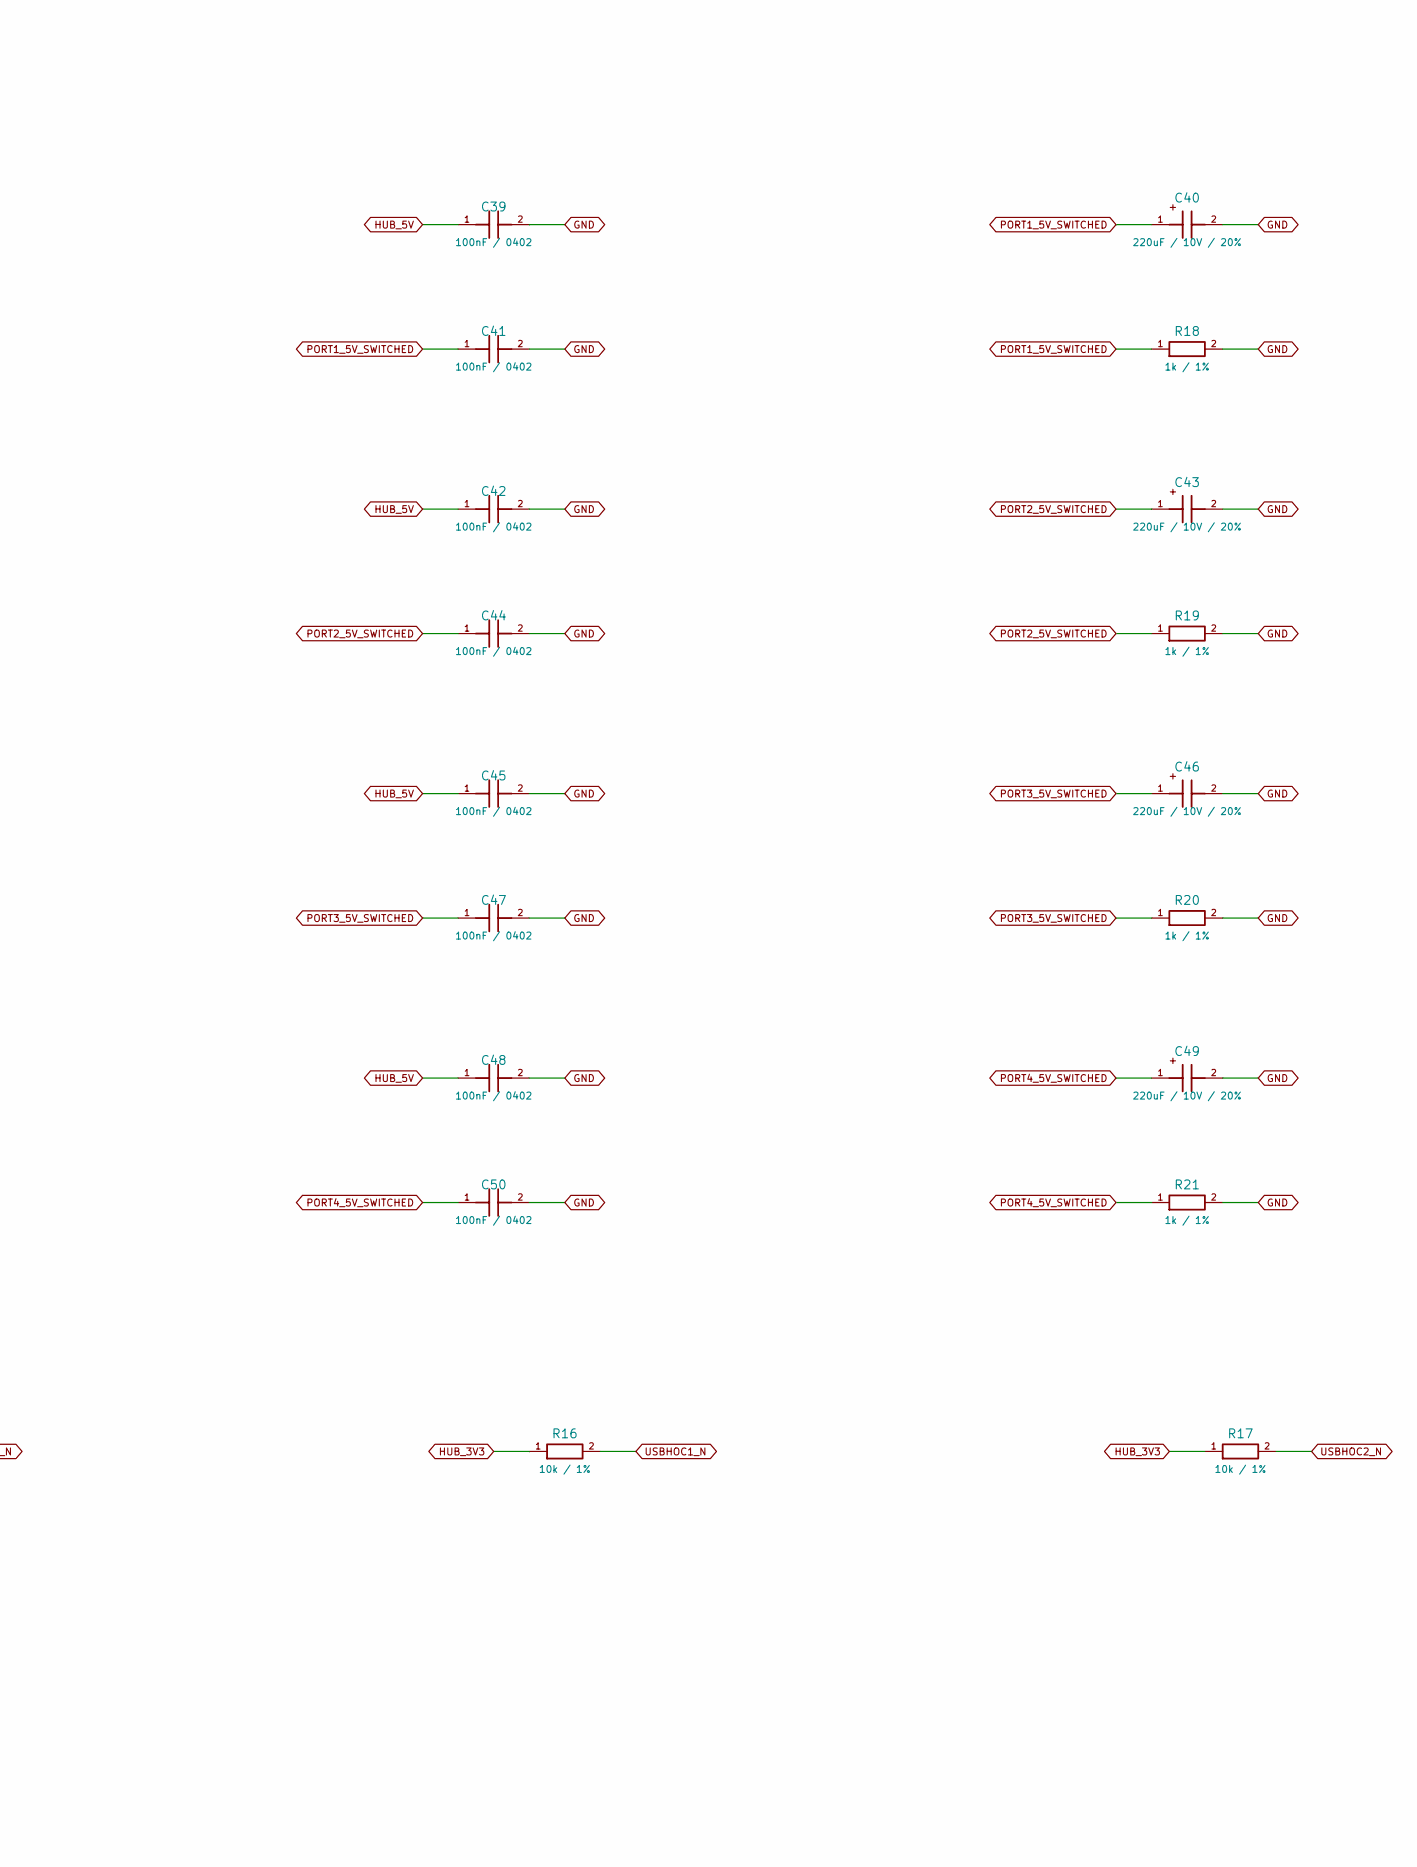
[picture p4: schematic port_power.kicad_sch, part in row 1, column 2]

Parts:
C39, C41, C42, C44, C45, C47, C48, C50, C51: 100nF / 0402; C_0402_1005Metric; MPN CL05B104KO5NNNC; LCSC C1525
C40, C43, C46, C49: 220uF / 10V / 20%
R10, R11, R12, R13: 23.2k / 1%; R_0603_1608Metric; MPN FRC0603F2322TS; LCSC C2930078
R14, R15, R16, R17: 10k / 1%; R_0603_1608Metric; MPN 0603WAF1002T5E; LCSC C25804
R18, R19, R20, R21: 1k / 1%; R_0603_1608Metric; MPN 0603WAF1001T5E; LCSC C21190
U2, U3, U4, U5: TPS2553DBVR; SOT-23-6; MPN TPS2553DBVR; LCSC C55266
U6: SN74LVC1G04DBVR; SOT-23-5; MPN SN74LVC1G04DBVR; LCSC C7827

Connections:
GND: C39.2, C40.2, C41.2, C42.2, C43.2, C44.2, C45.2, C46.2, C47.2, C48.2, C49.2, C50.2, C51.2, R10.2, R11.2, R12.2, R13.2, R15.2, R18.2, R19.2, R20.2, R21.2, U2.2 (GND), U3.2 (GND), U4.2 (GND), U5.2 (GND), U6.3 (GND)
HUB_3V3: C51.1, R14.1, R16.1, R17.1, U6.5 (VCC)
HUB_5V: C39.1, C42.1, C45.1, C48.1, U2.1 (IN), U3.1 (IN), U4.1 (IN), U5.1 (IN)
PORT1_5V_SWITCHED: C40.1, C41.1, R18.1, U2.6 (OUT)
PORT1_ILIM: R10.1, U2.5 (ILIM)
PORT2_5V_SWITCHED: C43.1, C44.1, R19.1, U3.6 (OUT)
PORT2_ILIM: R11.1, U3.5 (ILIM)
PORT3_5V_SWITCHED: C46.1, C47.1, R20.1, U4.6 (OUT)
PORT3_ILIM: R12.1, U4.5 (ILIM)
PORT4_5V_SWITCHED: C49.1, C50.1, R21.1, U5.6 (OUT)
PORT4_ILIM: R13.1, U5.5 (ILIM)
PORTS_EN: R15.1, U2.3 (EN), U3.3 (EN), U4.3 (EN), U5.3 (EN), U6.4 (Y)
USBHOC1_N: R16.2, U2.4 (FAULT_N), U3.4 (FAULT_N), U4.4 (FAULT_N), U5.4 (FAULT_N)
USBHOC2_N: R17.2
USBHPE1_N: R14.2, U6.2 (A)

Notes on the sheet:
FOUR CURRENT-LIMITED PORTS — GANGED ENABLE AND FAULT
23.2k / 1%: 1.024-1.208A current-limit range (TI Table 2); design load 0.9A per port. Fault outputs combine at USBHOC1_N; OUT rails remain independent. R18-R21 discharge output bulk.
U6 inverts USBHPE1_N. R14 defaults request OFF; R15 holds EN low with U6 unpowered (VCC=0). HOC2 is pulled inactive; unused charging-enable pin 42 is NC. Verify normal/gang firmware behavior. Require 5.0-5.2V at board under load. Input surge/budget, capacitor selection, ramps and thermal tests pend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
