5shekel/diffpair/kicad/usb3_sfp_hub/sfp_supply.kicad_sch

## KiCad design kicad/usb3_sfp_hub/sfp_supply.kicad_sch (2026-09-13)

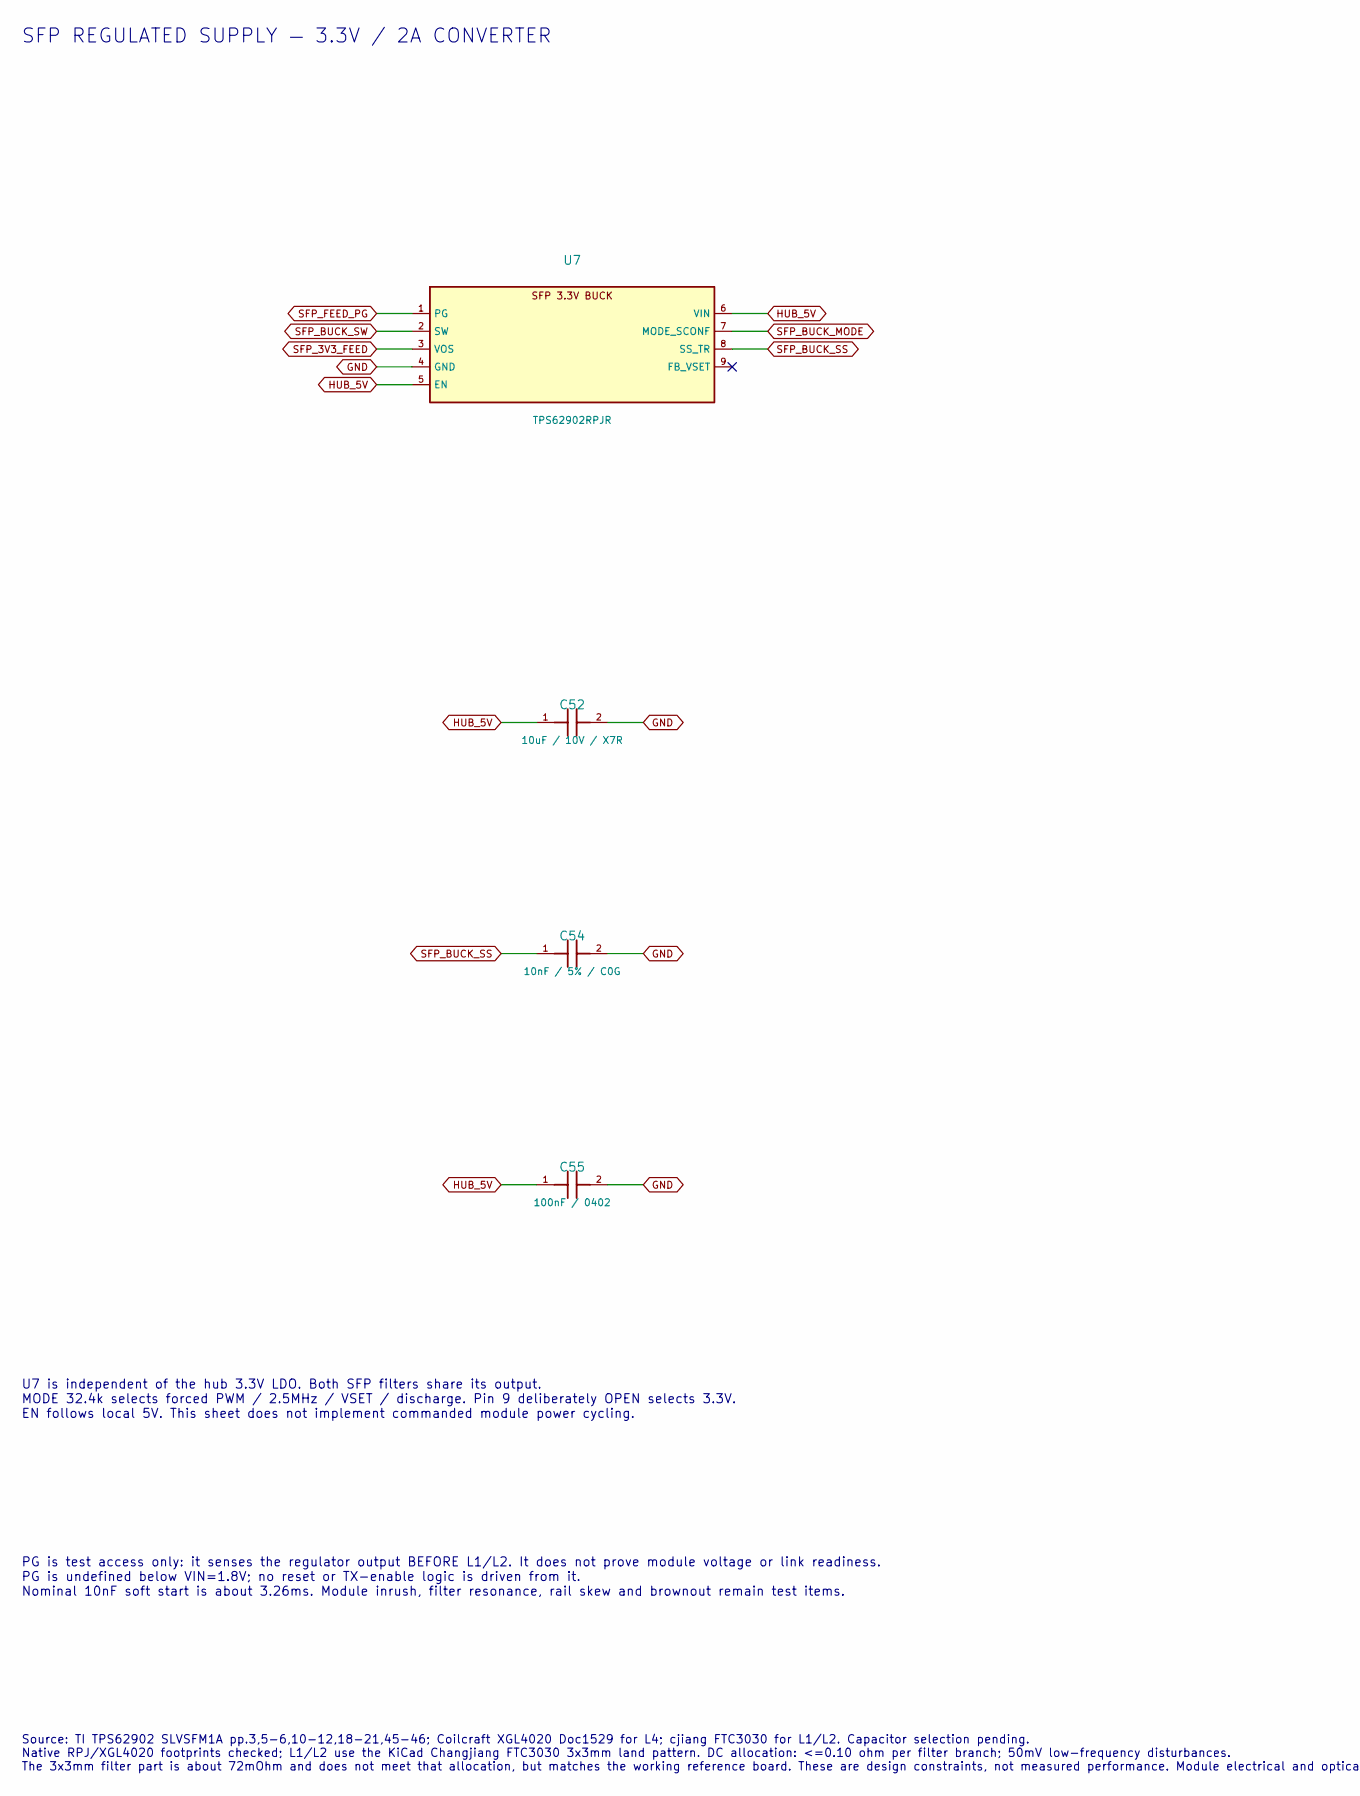
[picture p5: schematic sfp_supply.kicad_sch, part in row 1, column 1]

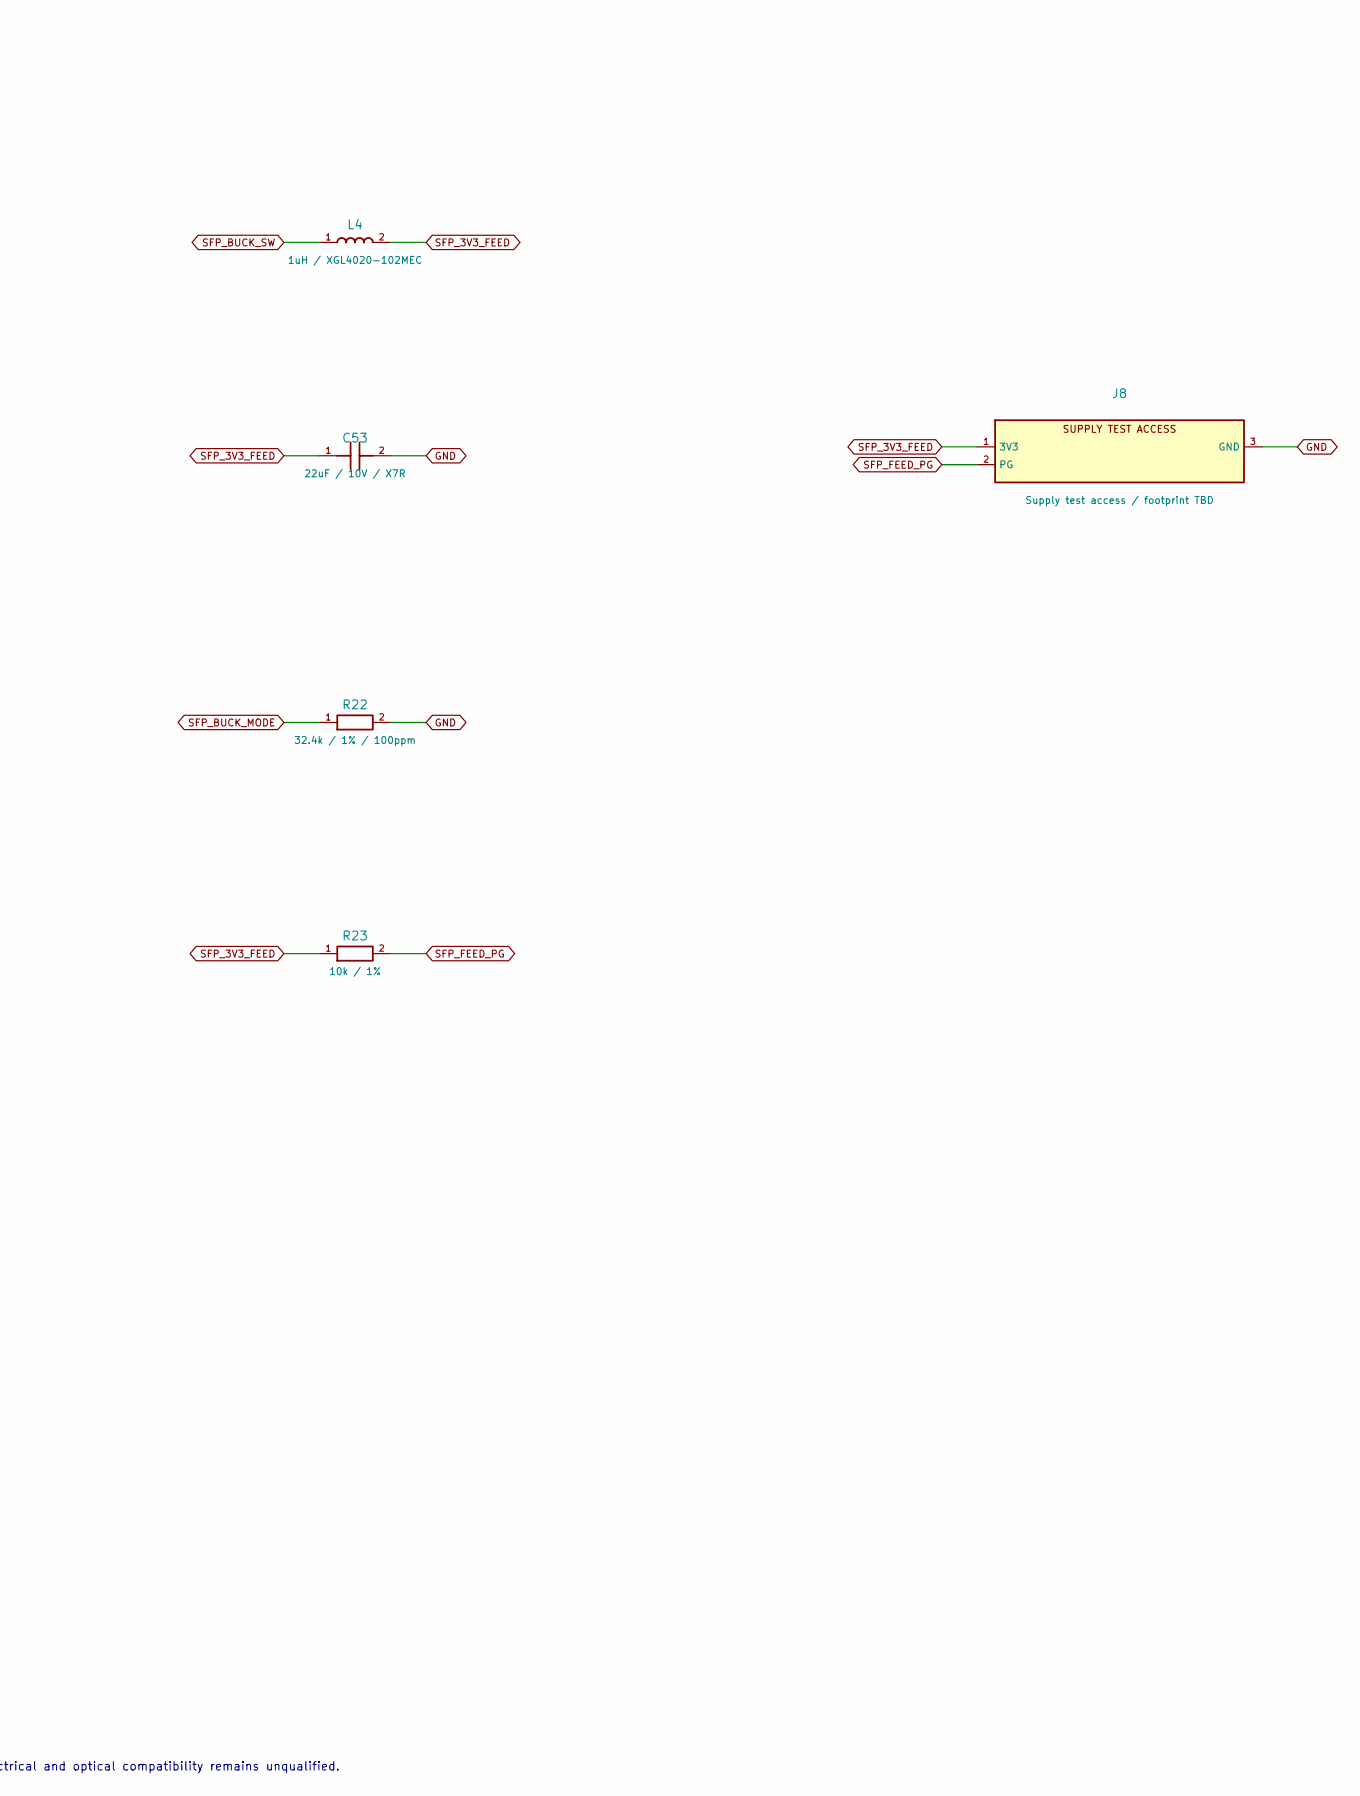
[picture p6: schematic sfp_supply.kicad_sch, part in row 1, column 2]

Parts:
C52: 10uF / 10V / X7R
C53: 22uF / 10V / X7R
C54: 10nF / 5% / C0G; C_0402_1005Metric
C55: 100nF / 0402; C_0402_1005Metric; MPN CL05B104KO5NNNC; LCSC C1525
J8: Supply test access / footprint TBD
L4: 1uH / XGL4020-102MEC; L_Coilcraft_XGL4020; MPN XGL4020-102MEC; LCSC C5357696
R22: 32.4k / 1% / 100ppm; R_0603_1608Metric; MPN FRC0603F3242TS; LCSC C2998122
R23: 10k / 1%; R_0603_1608Metric; MPN 0603WAF1002T5E; LCSC C25804
U7: TPS62902RPJR; TI_RPJ0009A_1.5x2mm; MPN TPS62902RPJR; LCSC C2870154

Connections:
GND: C52.2, C53.2, C54.2, C55.2, J8.3 (GND), R22.2, U7.4 (GND)
HUB_5V: C52.1, C55.1, U7.5 (EN), U7.6 (VIN)
SFP_3V3_FEED: C53.1, J8.1 (3V3), L4.2, R23.1, U7.3 (VOS)
SFP_BUCK_MODE: R22.1, U7.7 (MODE_SCONF)
SFP_BUCK_SS: C54.1, U7.8 (SS_TR)
SFP_BUCK_SW: L4.1, U7.2 (SW)
SFP_FEED_PG: J8.2 (PG), R23.2, U7.1 (PG)

Notes on the sheet:
SFP REGULATED SUPPLY — 3.3V / 2A CONVERTER
U7 is independent of the hub 3.3V LDO. Both SFP filters share its output. MODE 32.4k selects forced PWM / 2.5MHz / VSET / discharge. Pin 9 deliberately OPEN selects 3.3V. EN follows local 5V. This sheet does not implement commanded module power cycling.
PG is test access only: it senses the regulator output BEFORE L1/L2. It does not prove module voltage or link readiness. PG is undefined below VIN=1.8V; no reset or TX-enable logic is driven from it. Nominal 10nF soft start is about 3.26ms. Module inrush, filter resonance, rail skew and brownout re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
Source: TI TPS62902 SLVSFM1A pp.3,5-6,10-12,18-21,45-46; Coilcraft XGL4020 Doc1529 for L4; cjiang FTC3030 for L1/L2. Capacitor selection pending. Native RPJ/XGL4020 footprints checked; L1/L2 use the KiCad Changjiang FTC3030 3x3mm land pattern. DC allocation: <=0.10 ohm per filter branch; 50mV low-f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
