5shekel/diffpair/kicad/usb3_sfp_hub/sfp_support.kicad_sch

## KiCad design kicad/usb3_sfp_hub/sfp_support.kicad_sch (2026-09-13)

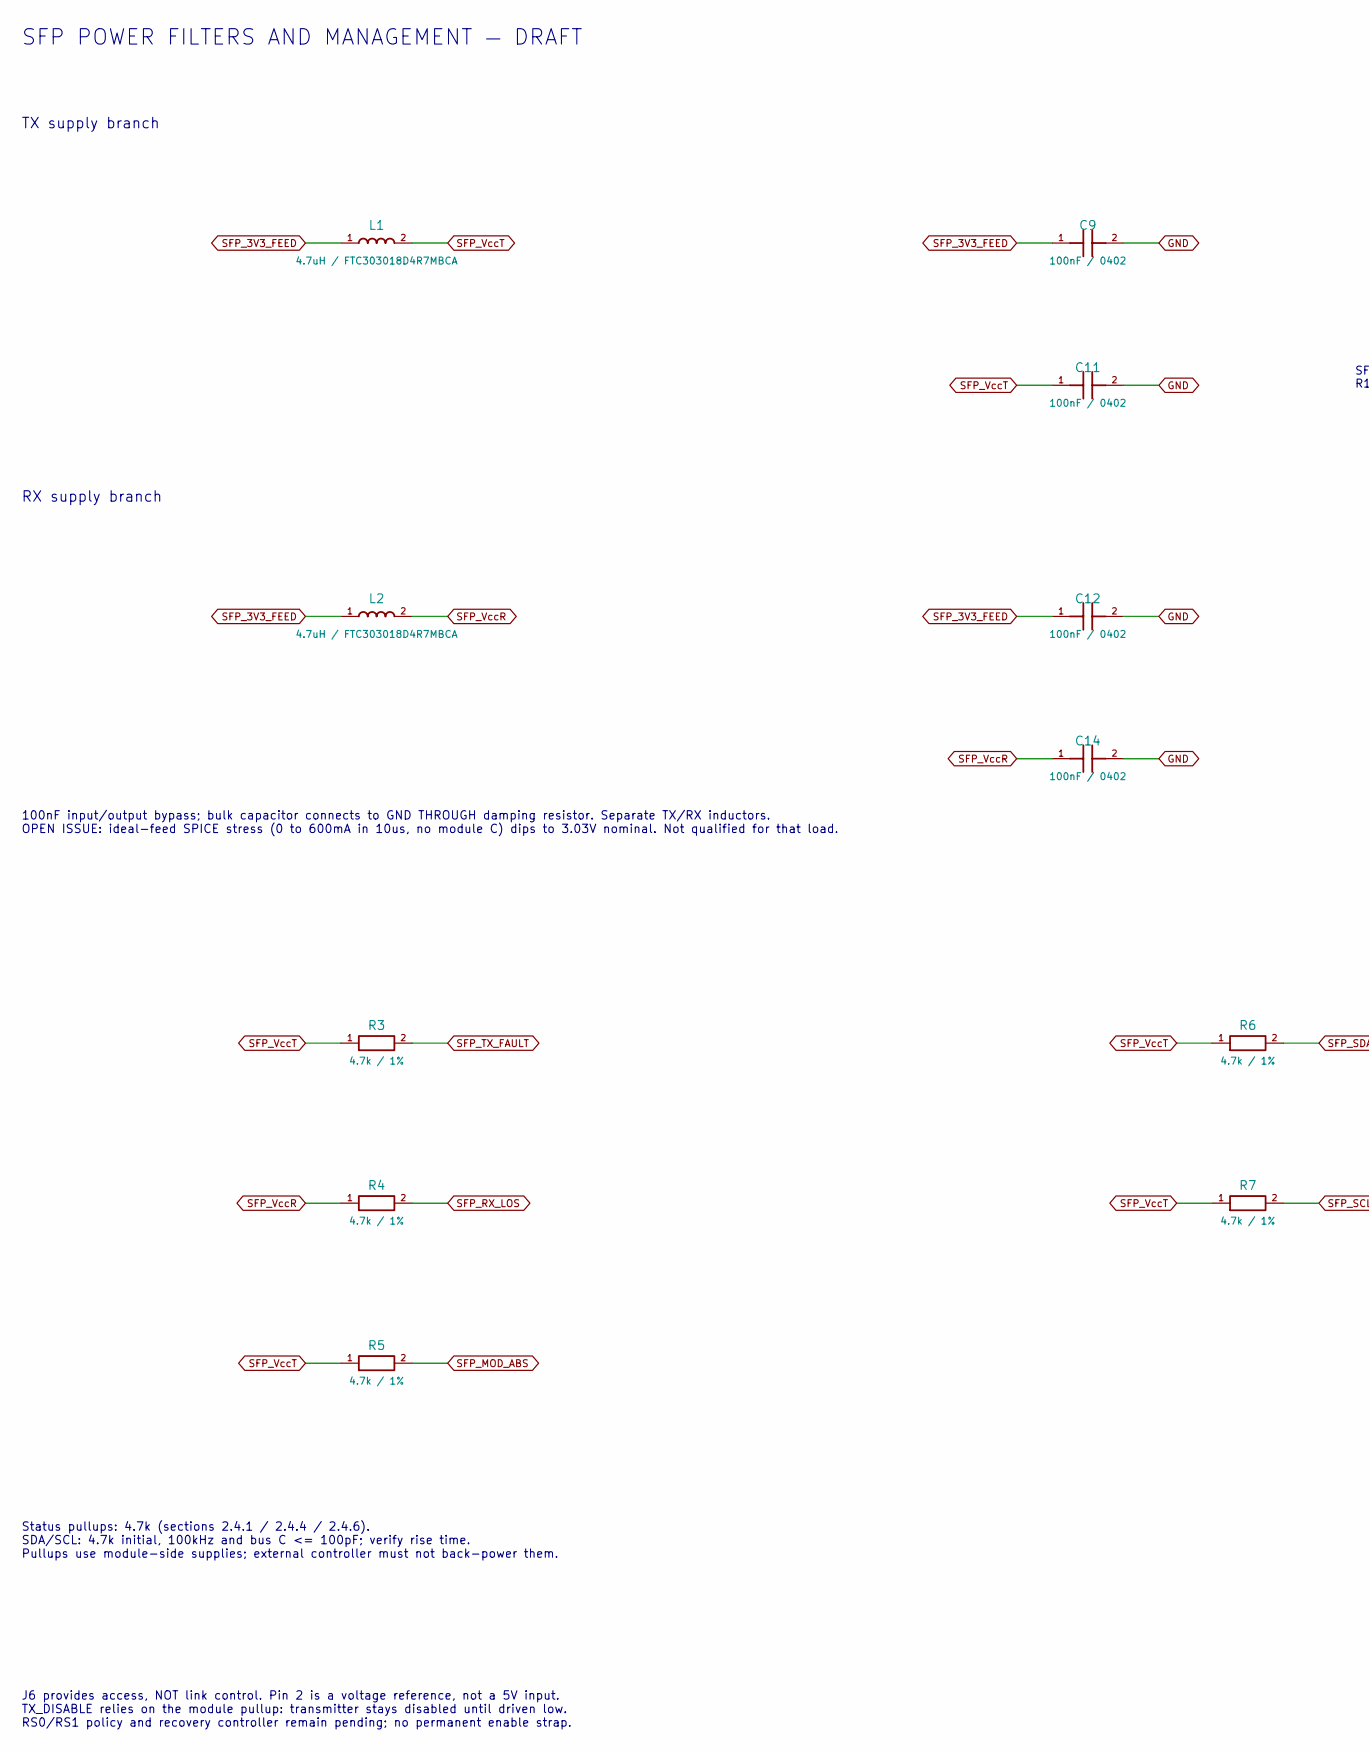
[picture p7: schematic sfp_support.kicad_sch, part in row 1, column 1]

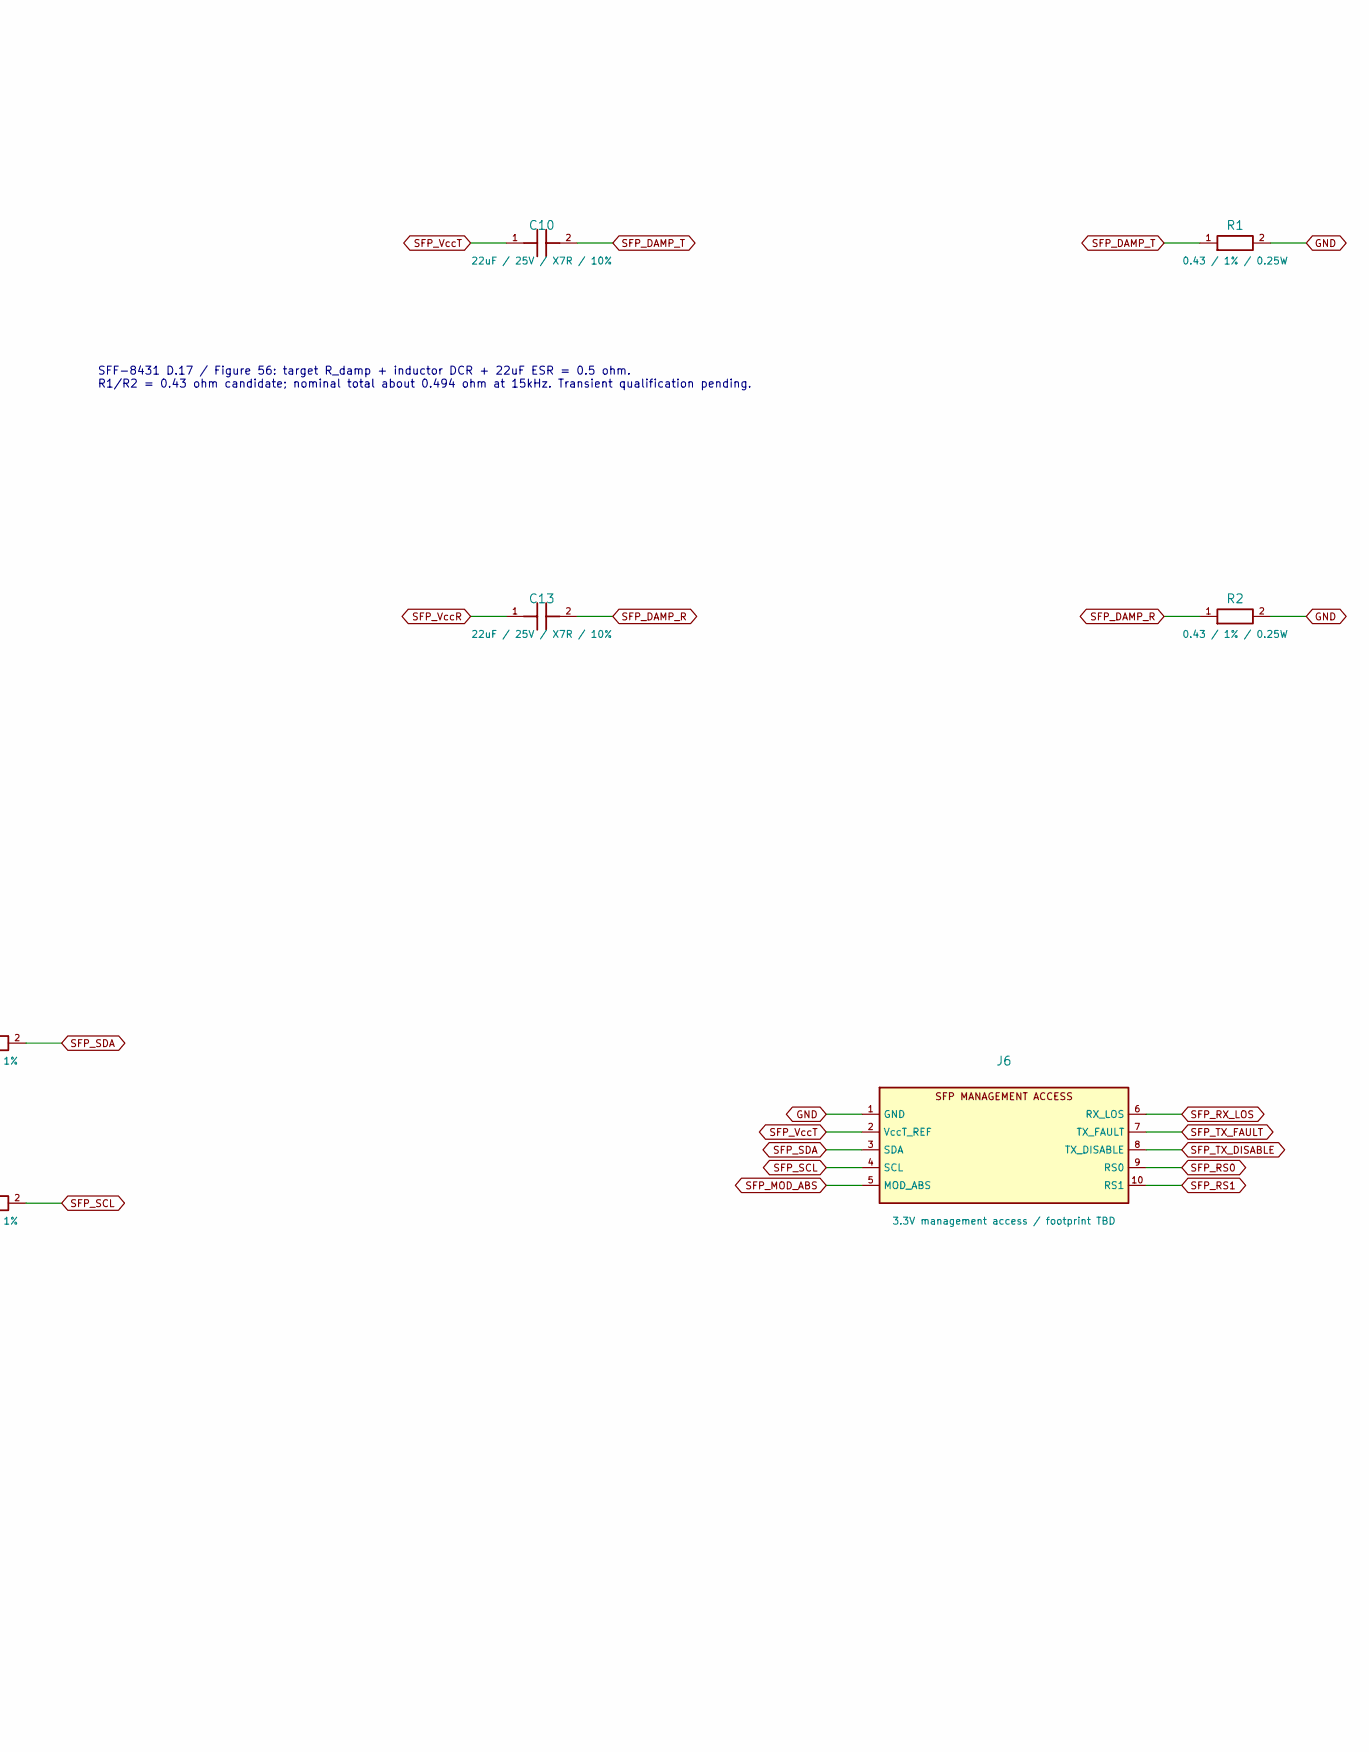
[picture p8: schematic sfp_support.kicad_sch, part in row 1, column 2]

Parts:
C9, C11, C12, C14: 100nF / 0402; C_0402_1005Metric; MPN CL05B104KO5NNNC; LCSC C1525
C10, C13: 22uF / 25V / X7R / 10%; C_1210_3225Metric; MPN GRM32ER71E226KE15L; LCSC C21397
J6: 3.3V management access / footprint TBD
L1, L2: 4.7uH / FTC303018D4R7MBCA; L_Changjiang_FTC303020D; MPN FTC303018D4R7MBCA; LCSC C5832388
R1, R2: 0.43 / 1% / 0.25W; R_1206_3216Metric; MPN RTF06KR430FTG; LCSC C44453441
R3, R4, R5, R6, R7: 4.7k / 1%; R_0603_1608Metric; MPN 0603WAF4701T5E; LCSC C23162

Connections:
GND: C9.2, C11.2, C12.2, C14.2, J6.1 (GND), R1.2, R2.2
SFP_3V3_FEED: C9.1, C12.1, L1.1, L2.1
SFP_DAMP_R: C13.2, R2.1
SFP_DAMP_T: C10.2, R1.1
SFP_MOD_ABS: J6.5 (MOD_ABS), R5.2
SFP_RS0: J6.9 (RS0)
SFP_RS1: J6.10 (RS1)
SFP_RX_LOS: J6.6 (RX_LOS), R4.2
SFP_SCL: J6.4 (SCL), R7.2
SFP_SDA: J6.3 (SDA), R6.2
SFP_TX_DISABLE: J6.8 (TX_DISABLE)
SFP_TX_FAULT: J6.7 (TX_FAULT), R3.2
SFP_VccR: C13.1, C14.1, L2.2, R4.1
SFP_VccT: C10.1, C11.1, J6.2 (VccT_REF), L1.2, R3.1, R5.1, R6.1, R7.1

Notes on the sheet:
SFP POWER FILTERS AND MANAGEMENT — DRAFT
TX supply branch
RX supply branch
SFF-8431 D.17 / Figure 56: target R_damp + inductor DCR + 22uF ESR = 0.5 ohm. R1/R2 = 0.43 ohm candidate; nominal total about 0.494 ohm at 15kHz. Transient qualification pending.
100nF input/output bypass; bulk capacitor connects to GND THROUGH damping resistor. Separate TX/RX inductors. OPEN ISSUE: ideal-feed SPICE stress (0 to 600mA in 10us, no module C) dips to 3.03V nominal. Not qualified for that load.
Status pullups: 4.7k (sections 2.4.1 / 2.4.4 / 2.4.6). SDA/SCL: 4.7k initial, 100kHz and bus C <= 100pF; verify rise time. Pullups use module-side supplies; external controller must not back-power them.
J6 provides access, NOT link control. Pin 2 is a voltage reference, not a 5V input. TX_DISABLE relies on the module pullup: transmitter stays disabled until driven low. RS0/RS1 policy and recovery controller remain pending; no permanent enable strap.
