5shekel/diffpair/kicad/usb3_sfp_hub/usb3_esd.kicad_sch

## KiCad design kicad/usb3_sfp_hub/usb3_esd.kicad_sch (2026-09-13)

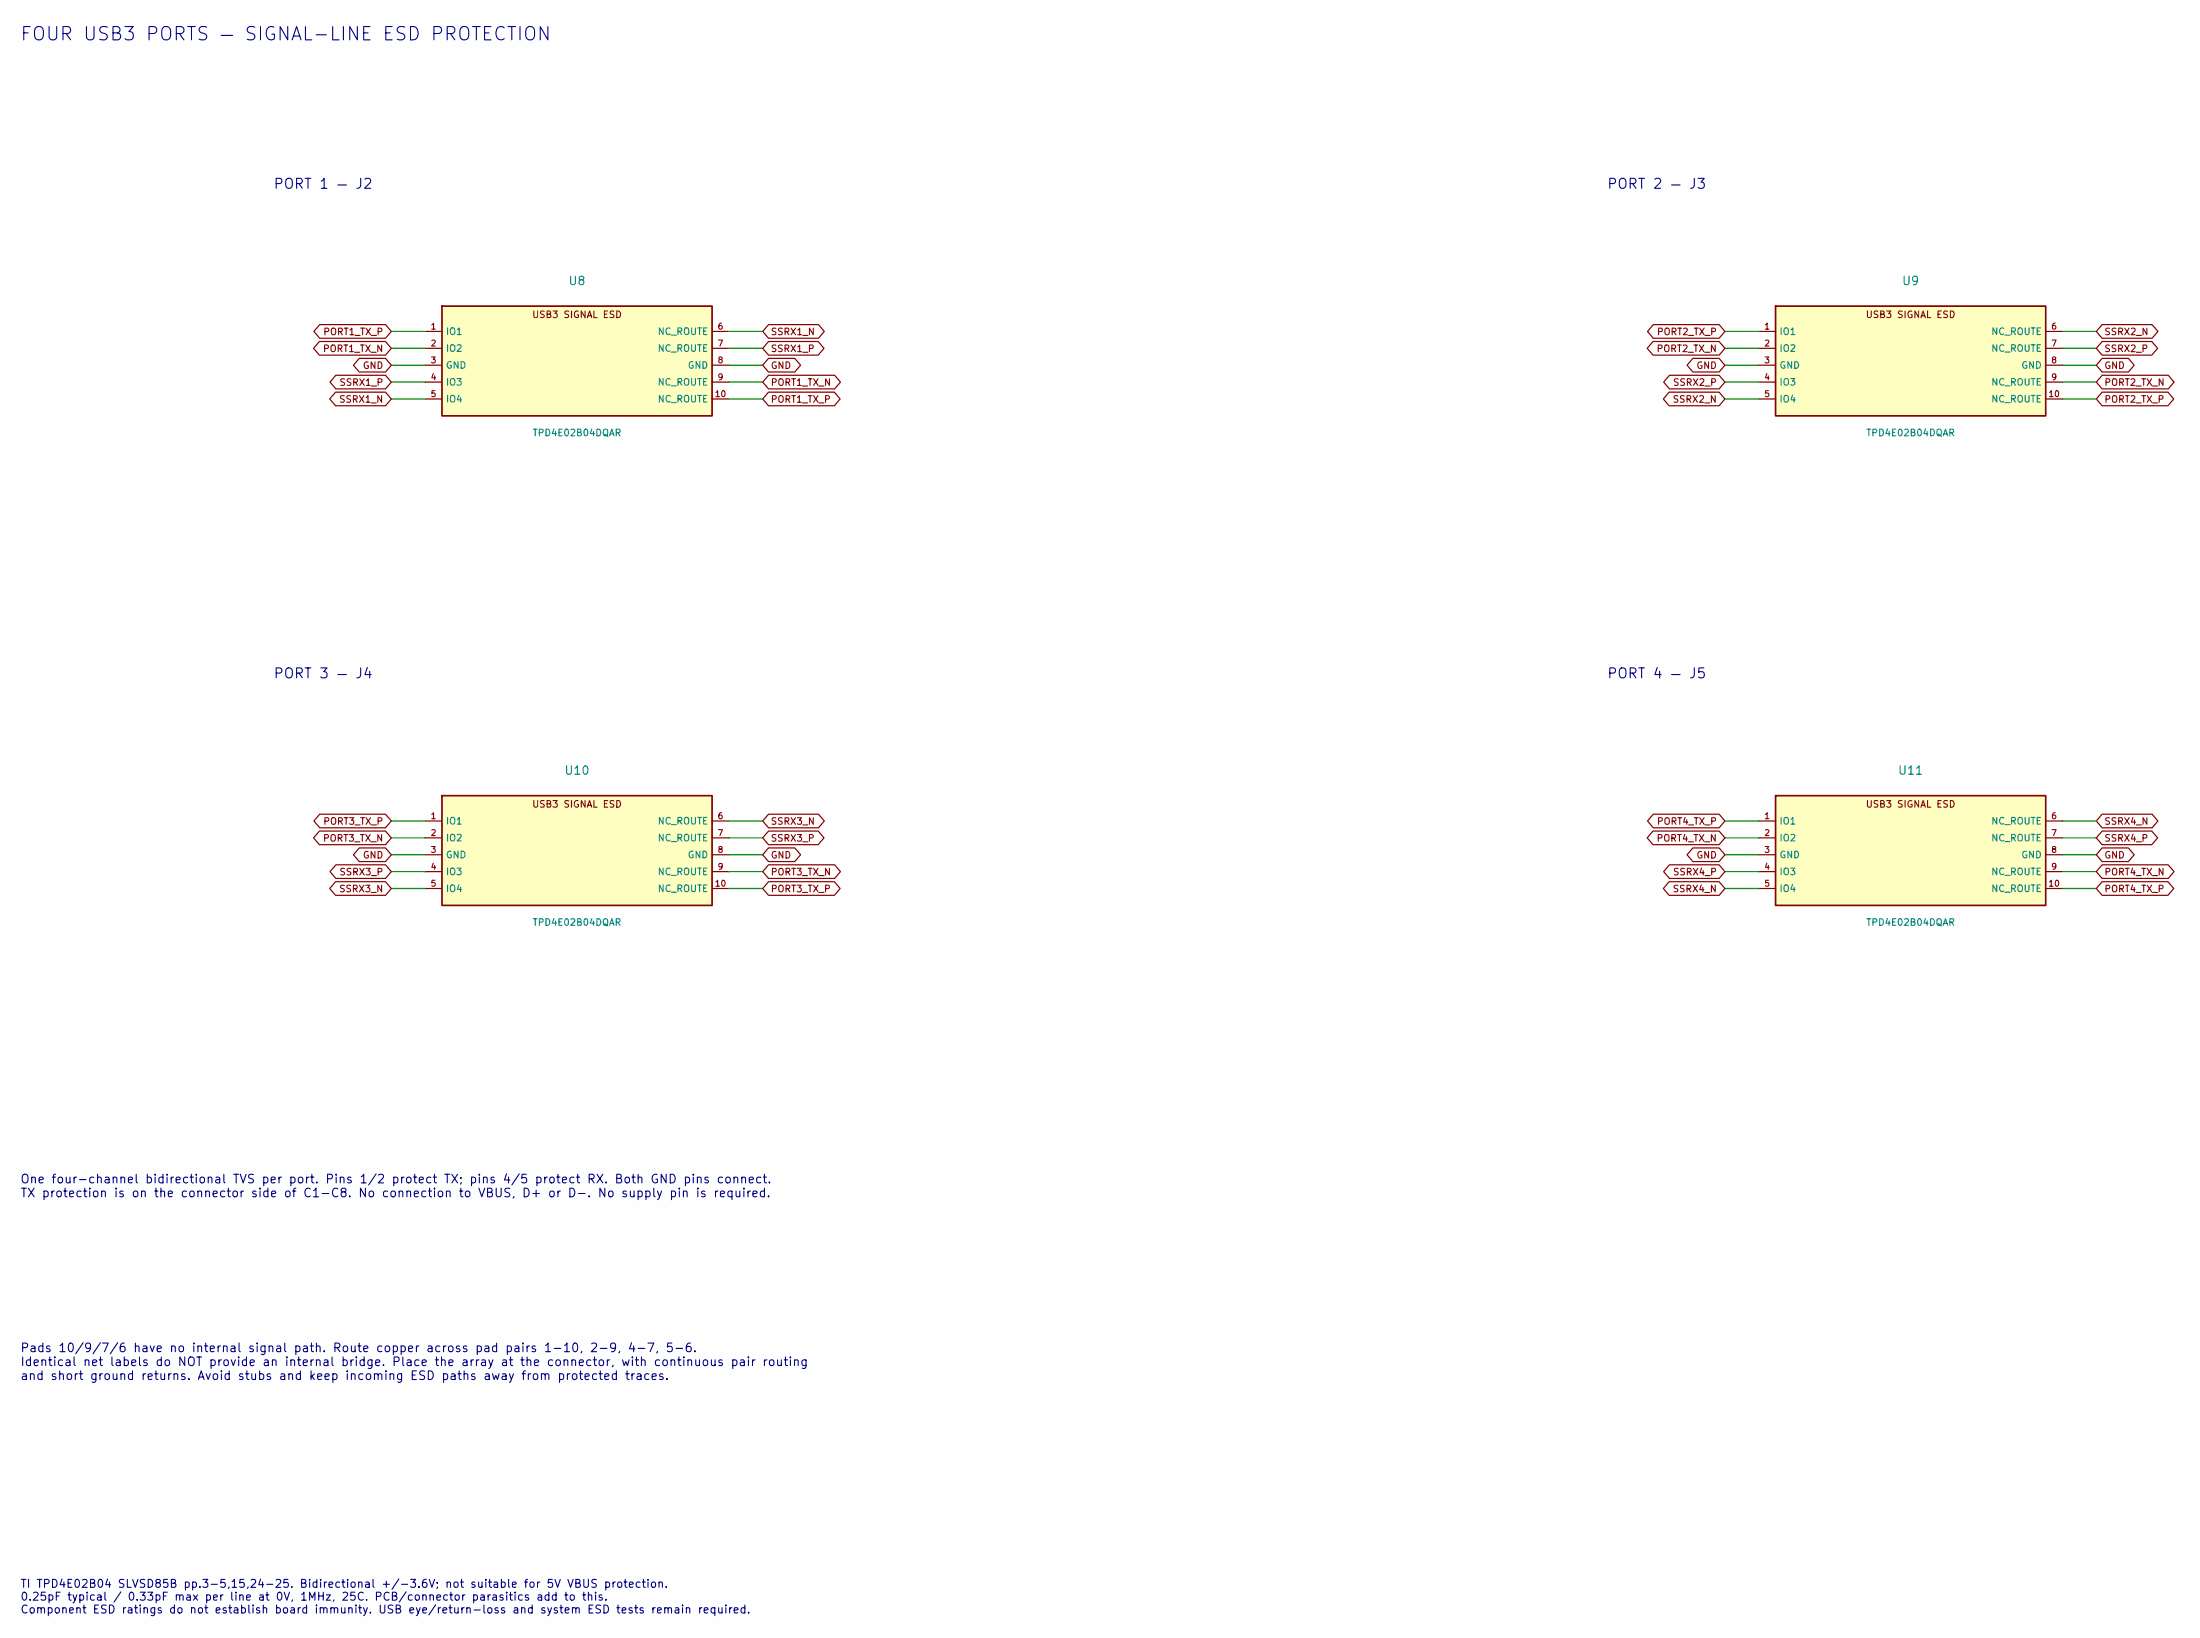
[picture p9: schematic usb3_esd.kicad_sch]

Parts:
U8, U9, U10, U11: TPD4E02B04DQAR; TI_DQA0010A_1x2.5mm; MPN TPD4E02B04DQAR; LCSC C106794

Connections:
GND: U8.3 (GND), U8.8 (GND), U9.3 (GND), U9.8 (GND), U10.3 (GND), U10.8 (GND), U11.3 (GND), U11.8 (GND)
PORT1_TX_N: U8.2 (IO2), U8.9 (NC_ROUTE)
PORT1_TX_P: U8.1 (IO1), U8.10 (NC_ROUTE)
PORT2_TX_N: U9.2 (IO2), U9.9 (NC_ROUTE)
PORT2_TX_P: U9.1 (IO1), U9.10 (NC_ROUTE)
PORT3_TX_N: U10.2 (IO2), U10.9 (NC_ROUTE)
PORT3_TX_P: U10.1 (IO1), U10.10 (NC_ROUTE)
PORT4_TX_N: U11.2 (IO2), U11.9 (NC_ROUTE)
PORT4_TX_P: U11.1 (IO1), U11.10 (NC_ROUTE)
SSRX1_N: U8.5 (IO4), U8.6 (NC_ROUTE)
SSRX1_P: U8.4 (IO3), U8.7 (NC_ROUTE)
SSRX2_N: U9.5 (IO4), U9.6 (NC_ROUTE)
SSRX2_P: U9.4 (IO3), U9.7 (NC_ROUTE)
SSRX3_N: U10.5 (IO4), U10.6 (NC_ROUTE)
SSRX3_P: U10.4 (IO3), U10.7 (NC_ROUTE)
SSRX4_N: U11.5 (IO4), U11.6 (NC_ROUTE)
SSRX4_P: U11.4 (IO3), U11.7 (NC_ROUTE)

Notes on the sheet:
PORT 1 — J2
PORT 2 — J3
PORT 3 — J4
PORT 4 — J5
FOUR USB3 PORTS — SIGNAL-LINE ESD PROTECTION
One four-channel bidirectional TVS per port. Pins 1/2 protect TX; pins 4/5 protect RX. Both GND pins connect. TX protection is on the connector side of C1-C8. No connection to VBUS, D+ or D-. No supply pin is required.
Pads 10/9/7/6 have no internal signal path. Route copper across pad pairs 1-10, 2-9, 4-7, 5-6. Identical net labels do NOT provide an internal bridge. Place the array at the connector, with continuous pair routing and short ground returns. Avoid stubs and keep incoming ESD paths away from protected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
TI TPD4E02B04 SLVSD85B pp.3-5,15,24-25. Bidirectional +/-3.6V; not suitable for 5V VBUS protection. 0.25pF typical / 0.33pF max per line at 0V, 1MHz, 25C. PCB/connector parasitics add to this. Component ESD ratings do not establish board immunity. USB eye/return-loss and system ESD tests remain req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
