5shekel/diffpair/kicad/usb3_sfp_hub/usb3_sfp_hub.kicad_sch

## KiCad design kicad/usb3_sfp_hub/usb3_sfp_hub.kicad_sch (2026-09-13)

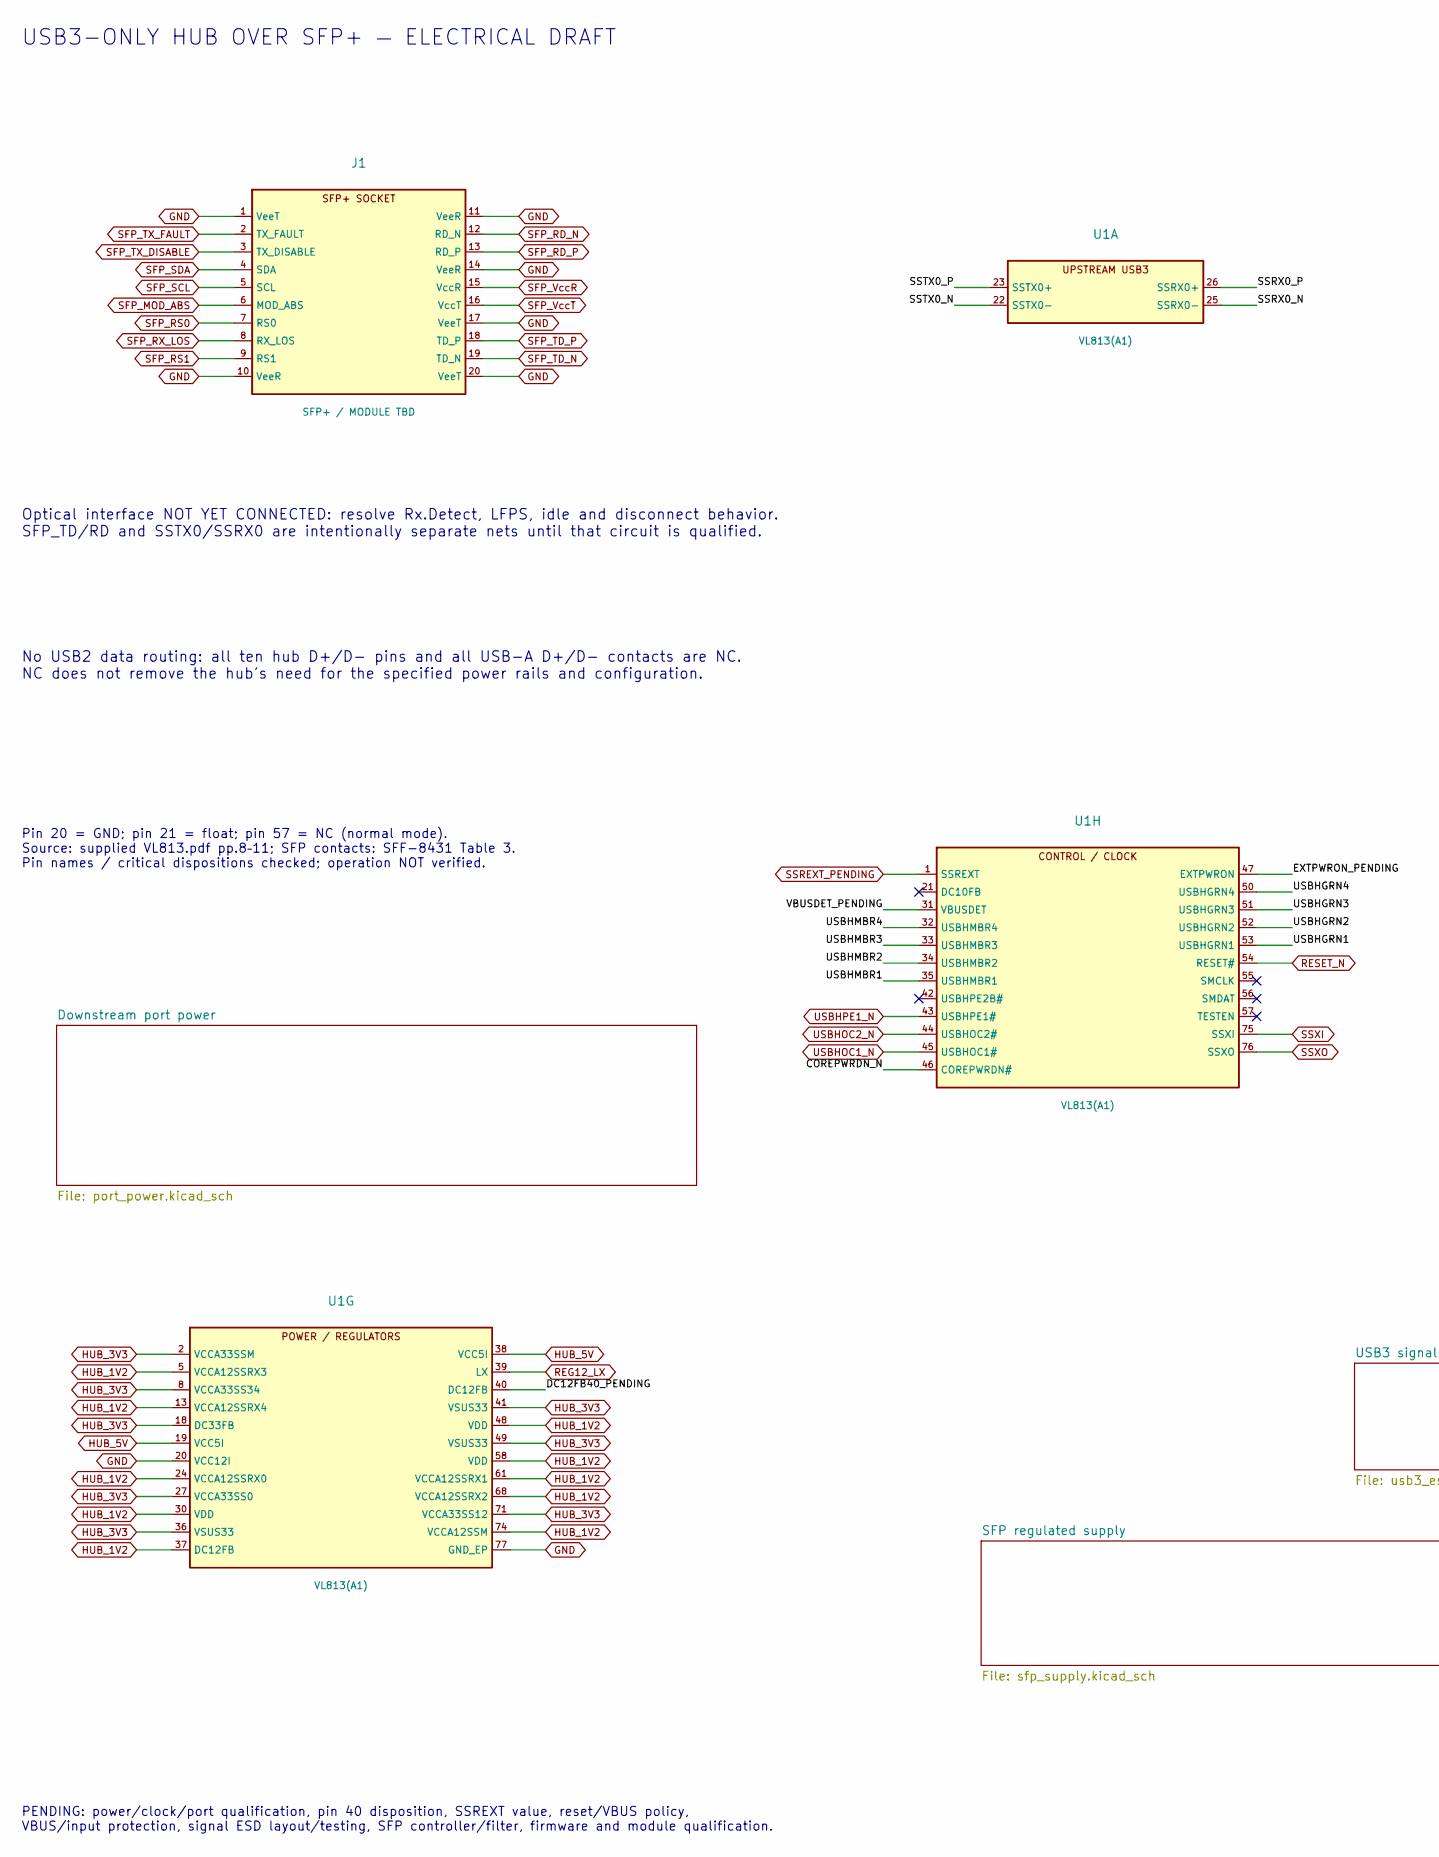
[picture p10: schematic usb3_sfp_hub.kicad_sch, part in row 1, column 1]

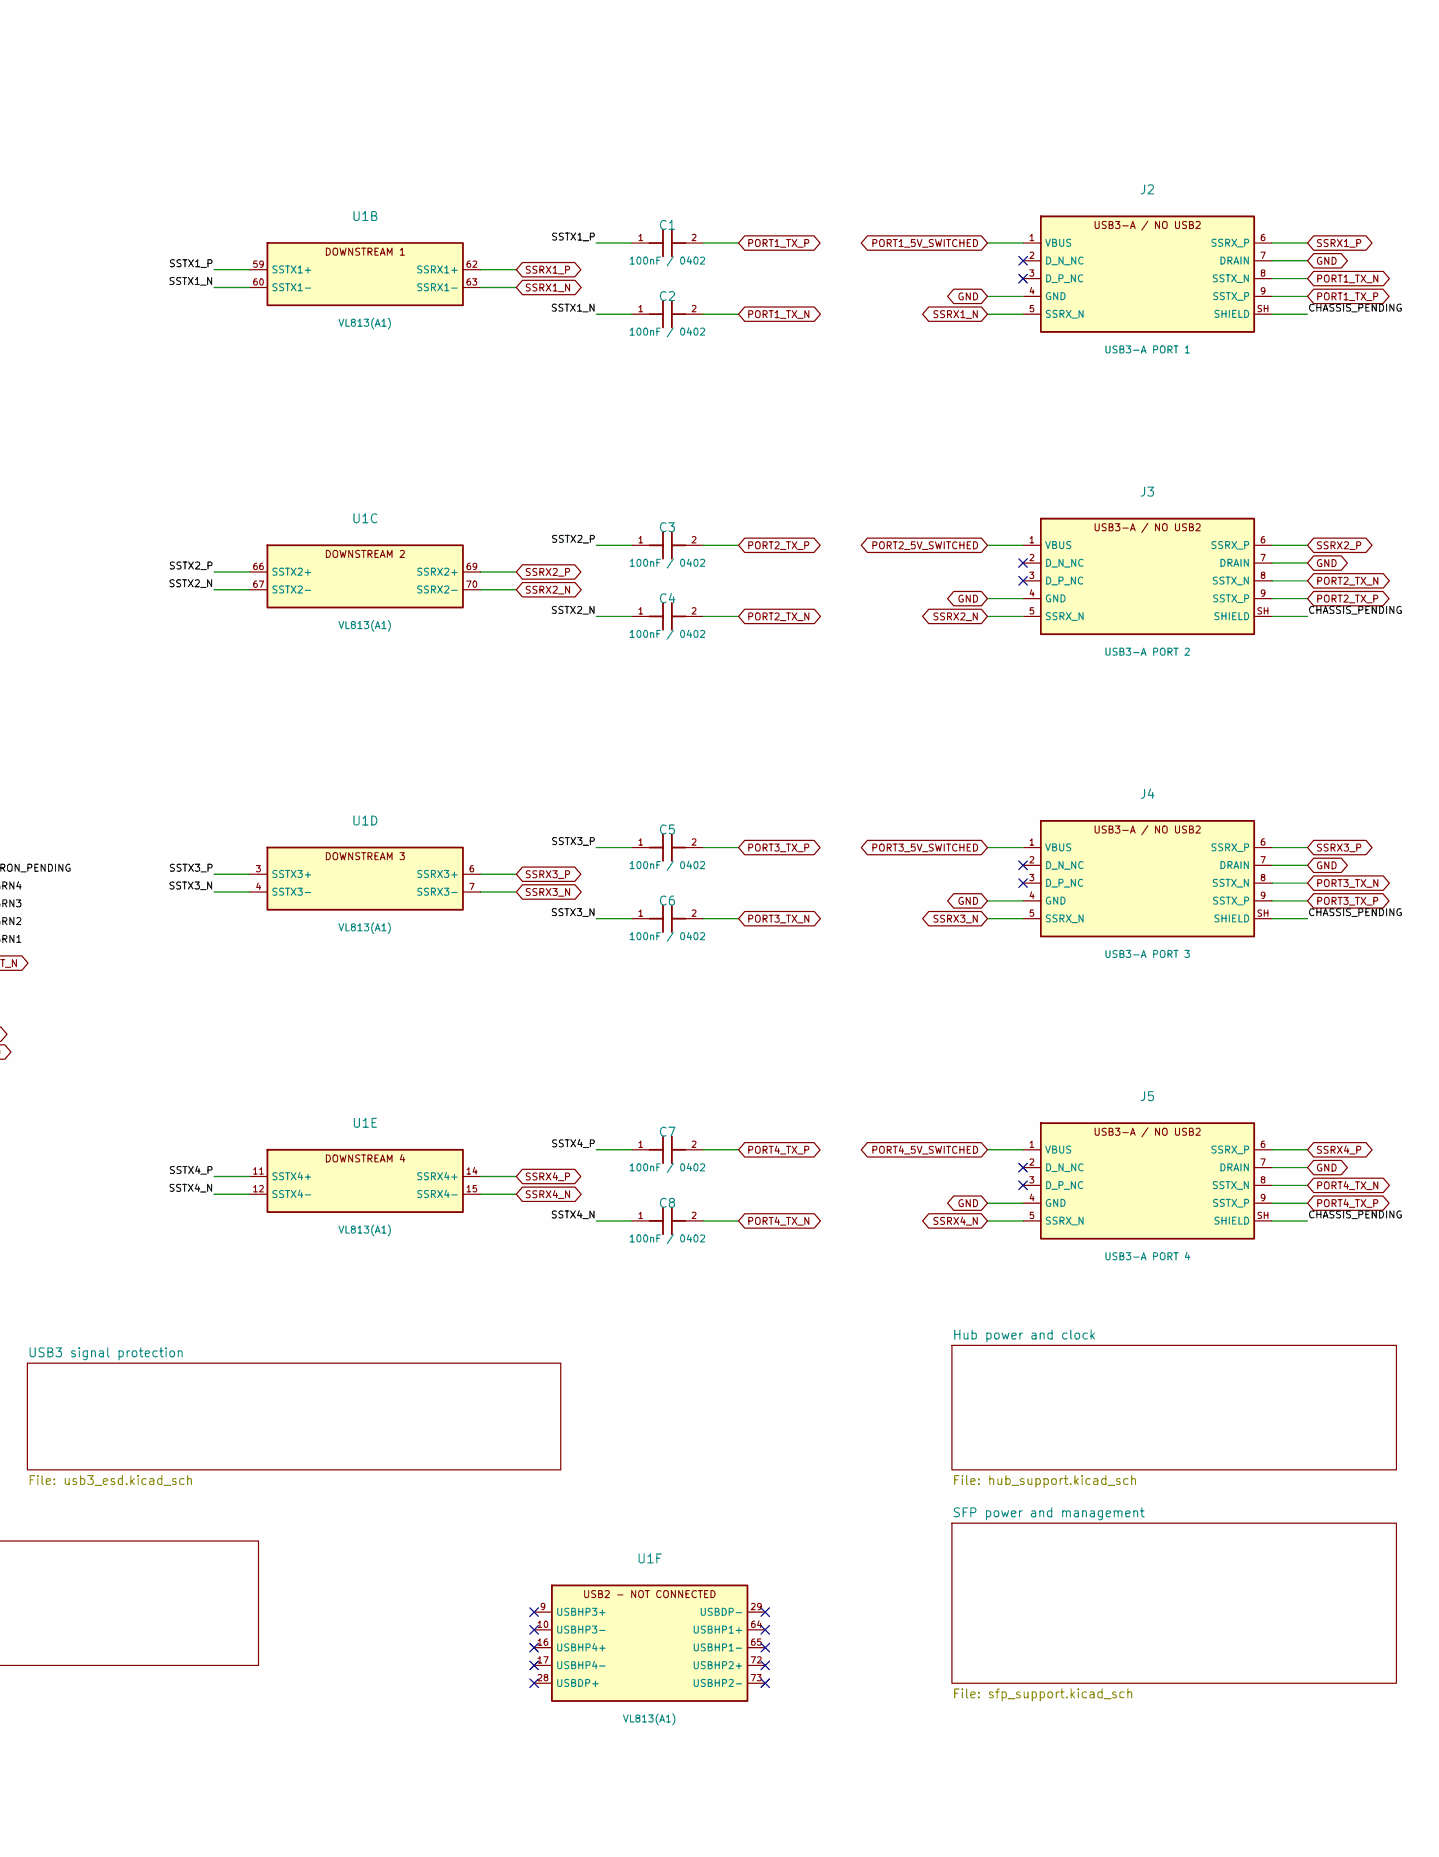
[picture p11: schematic usb3_sfp_hub.kicad_sch, part in row 1, column 2]

Parts:
C1, C2, C3, C4, C5, C6, C7, C8: 100nF / 0402; C_0402_1005Metric; MPN CL05B104KO5NNNC; LCSC C1525
J1: SFP+ / MODULE TBD
J2: USB3-A PORT 1
J3: USB3-A PORT 2
J4: USB3-A PORT 3
J5: USB3-A PORT 4
U1: VL813(A1); C69418_QFN-76_L9_0-W9_0-P0_40-EP6_4-TL; MPN VL813(A1)

Connections:
CHASSIS_PENDING: J2.SH (SHIELD), J3.SH (SHIELD), J4.SH (SHIELD), J5.SH (SHIELD)
COREPWRDN_N: U1.46 (COREPWRDN#)
DC12FB40_PENDING: U1.40 (DC12FB)
EXTPWRON_PENDING: U1.47 (EXTPWRON)
GND: J1.1 (VeeT), J1.10 (VeeR), J1.11 (VeeR), J1.14 (VeeR), J1.17 (VeeT), J1.20 (VeeT), J2.4 (GND), J2.7 (DRAIN), J3.4 (GND), J3.7 (DRAIN), J4.4 (GND), J4.7 (DRAIN), J5.4 (GND), J5.7 (DRAIN), U1.20 (VCC12I), U1.77 (GND_EP)
HUB_1V2: U1.5 (VCCA12SSRX3), U1.13 (VCCA12SSRX4), U1.24 (VCCA12SSRX0), U1.30 (VDD), U1.37 (DC12FB), U1.48 (VDD), U1.58 (VDD), U1.61 (VCCA12SSRX1), U1.68 (VCCA12SSRX2), U1.74 (VCCA12SSM)
HUB_3V3: U1.2 (VCCA33SSM), U1.8 (VCCA33SS34), U1.18 (DC33FB), U1.27 (VCCA33SS0), U1.36 (VSUS33), U1.41 (VSUS33), U1.49 (VSUS33), U1.71 (VCCA33SS12)
HUB_5V: U1.19 (VCC5I), U1.38 (VCC5I)
PORT1_5V_SWITCHED: J2.1 (VBUS)
PORT1_TX_N: C2.2, J2.8 (SSTX_N)
PORT1_TX_P: C1.2, J2.9 (SSTX_P)
PORT2_5V_SWITCHED: J3.1 (VBUS)
PORT2_TX_N: C4.2, J3.8 (SSTX_N)
PORT2_TX_P: C3.2, J3.9 (SSTX_P)
PORT3_5V_SWITCHED: J4.1 (VBUS)
PORT3_TX_N: C6.2, J4.8 (SSTX_N)
PORT3_TX_P: C5.2, J4.9 (SSTX_P)
PORT4_5V_SWITCHED: J5.1 (VBUS)
PORT4_TX_N: C8.2, J5.8 (SSTX_N)
PORT4_TX_P: C7.2, J5.9 (SSTX_P)
REG12_LX: U1.39 (LX)
RESET_N: U1.54 (RESET#)
SFP_MOD_ABS: J1.6 (MOD_ABS)
SFP_RD_N: J1.12 (RD_N)
SFP_RD_P: J1.13 (RD_P)
SFP_RS0: J1.7 (RS0)
SFP_RS1: J1.9 (RS1)
SFP_RX_LOS: J1.8 (RX_LOS)
SFP_SCL: J1.5 (SCL)
SFP_SDA: J1.4 (SDA)
SFP_TD_N: J1.19 (TD_N)
SFP_TD_P: J1.18 (TD_P)
SFP_TX_DISABLE: J1.3 (TX_DISABLE)
SFP_TX_FAULT: J1.2 (TX_FAULT)
SFP_VccR: J1.15 (VccR)
SFP_VccT: J1.16 (VccT)
SSREXT_PENDING: U1.1 (SSREXT)
SSRX0_N: U1.25 (SSRX0-)
SSRX0_P: U1.26 (SSRX0+)
SSRX1_N: J2.5 (SSRX_N), U1.63 (SSRX1-)
SSRX1_P: J2.6 (SSRX_P), U1.62 (SSRX1+)
SSRX2_N: J3.5 (SSRX_N), U1.70 (SSRX2-)
SSRX2_P: J3.6 (SSRX_P), U1.69 (SSRX2+)
SSRX3_N: J4.5 (SSRX_N), U1.7 (SSRX3-)
SSRX3_P: J4.6 (SSRX_P), U1.6 (SSRX3+)
SSRX4_N: J5.5 (SSRX_N), U1.15 (SSRX4-)
SSRX4_P: J5.6 (SSRX_P), U1.14 (SSRX4+)
SSTX0_N: U1.22 (SSTX0-)
SSTX0_P: U1.23 (SSTX0+)
SSTX1_N: C2.1, U1.60 (SSTX1-)
SSTX1_P: C1.1, U1.59 (SSTX1+)
SSTX2_N: C4.1, U1.67 (SSTX2-)
SSTX2_P: C3.1, U1.66 (SSTX2+)
SSTX3_N: C6.1, U1.4 (SSTX3-)
SSTX3_P: C5.1, U1.3 (SSTX3+)
SSTX4_N: C8.1, U1.12 (SSTX4-)
SSTX4_P: C7.1, U1.11 (SSTX4+)
SSXI: U1.75 (SSXI)
SSXO: U1.76 (SSXO)
USBHGRN1: U1.53 (USBHGRN1)
USBHGRN2: U1.52 (USBHGRN2)
USBHGRN3: U1.51 (USBHGRN3)
USBHGRN4: U1.50 (USBHGRN4)
USBHMBR1: U1.35 (USBHMBR1)
USBHMBR2: U1.34 (USBHMBR2)
USBHMBR3: U1.33 (USBHMBR3)
USBHMBR4: U1.32 (USBHMBR4)
USBHOC1_N: U1.45 (USBHOC1#)
USBHOC2_N: U1.44 (USBHOC2#)
USBHPE1_N: U1.43 (USBHPE1#)
VBUSDET_PENDING: U1.31 (VBUSDET)

Notes on the sheet:
USB3-ONLY HUB OVER SFP+ — ELECTRICAL DRAFT
Optical interface NOT YET CONNECTED: resolve Rx.Detect, LFPS, idle and disconnect behavior. SFP_TD/RD and SSTX0/SSRX0 are intentionally separate nets until that circuit is qualified.
No USB2 data routing: all ten hub D+/D- pins and all USB-A D+/D- contacts are NC. NC does not remove the hub's need for the specified power rails and configuration.
PENDING: power/clock/port qualification, pin 40 disposition, SSREXT value, reset/VBUS policy, VBUS/input protection, signal ESD layout/testing, SFP controller/filter, firmware and module qualification.
Pin 20 = GND; pin 21 = float; pin 57 = NC (normal mode). Source: supplied VL813.pdf pp.8–11; SFP contacts: SFF-8431 Table 3. Pin names / critical dispositions checked; operation NOT verified.
