5shekel/diffpair/(commit log)

2026-08-22 Initial commit: USB3-over-optical hub reverse-engineering project
    VL813 hub + SFP breakout pinout mapper, KiCad project, board photos/
    tracing, and reference datasheets. default.json now seeds the mapper's
    default GND pin placements and updated SFP pinout SVG.
    [usb3_over_optical_hub.kicad_pcb, usb3_over_optical_hub.kicad_sch]
2026-08-25 Add AI Console panel to diffpair mapper
    - Floating toggle button (Ctrl+Shift+L) and slide-in side panel
    - Chat input to request page edits, sent to watchdog agent
    - Connection status dot, health display, and restart button
    - Reload banner when a new page version lands on disk
    - Commit history list with per-commit revert buttons
2026-08-25 Add watchdog AI agent, public gate, and docs; tighten .gitignore
    - watchdog.js: local AI console agent (serves page, applies committed
    edits, exposes /api endpoints)
    - webroot/gate.js: path-filtering public gate in front of watchdog,
    protecting .env/.git/.versions/logs
    - AI-CONSOLE.md, SHARE.md: usage and tunnel-sharing docs
    - .gitignore: exclude .env (contains GitHub PAT), *.log, .versions/,
    and webroot/*.html (runtime copies of the mapper page)
2026-08-25 Scope the file watcher to the mapper page, add control-plane drift alerts
    Finding #15 (never actually given a task number): the directory watcher
    re-hashed the 2 MB page on any change anywhere in the project root,
    including log writes and photo touches. fs.watch now filters on filename
    and only reacts to diffpair-mapper.html.
    That fix has a sharp edge: it means the watchdog now ignores everything
    except its own target file, so an edit to watchdog.js or gate.js itself
    (by an AI agent or anyone else) would go completely undetected by the
    running process. Added control-plane drift detection to close that gap —
    boot-time hash of both files, instant check for watchdog.js via the same
    watcher,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
2026-08-25 Silence agent.log growth and add stale-tab reload detection
    agent.log was growing unbounded from zrok's per-request access logging,
    driven by browser tabs still running pre-T17 JS that polled /api/status
    every 4s. Filter those access-log lines out of the agent's stdout at the
    source (see SHARE.md); document the agent-registry replay gotcha hit
    while restarting zrok cleanly. Also add checkDrift() to the AI Console
    panel's poller so a stale tab (SSE or poller-only) notices its commit
    hash is behind and offers a reload, instead of drifting silently forever.
    Claude-Session: https://claude.ai/code/session_01XAjPWX4JHraa39NGKNvoVe
2026-08-25 Wire the AI Console to a real agent, log every run next to its commit
    Instructions were only ever logged to a terminal for a human to read and
    act on by hand. watchdog.js now spawns a headless `claude -p` agent per
    instruction (Read/Edit/Glob/Grep only, cwd-locked, serialized) and the
    resulting commit is tagged with the run that produced it, so the panel's
    new "Agent runs" section and the commit list's "log" button can show
    exactly what the AI did and why. Rate-limits /api/instruction since it's
    already public.
    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
2026-08-27 Surface agent run traces in the AI Console; checkpoint recent live edits
    Adds a collapsed-by-default "trace" toggle to each run's detail panel,
    pulling the tool-call/narration trace from the agent's own Claude Code
    session transcript on demand (GET /api/run now attaches it when a
    sessionId is present) rather than duplicating it in .versions/runs/.
    Nothing is auto-expanded or auto-fetched on open — only on click.
    Also checkpoints several live AI Console edits made directly to
    diffpair-mapper.html since the last commit: shimmering title text, the
    console toggle moved to the top-right, and a VCC/GND-short easter egg
    (burn animation, roach crawl, joke "Pro" paywall) plus a manual burn-sim
    tri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
2026-09-11 Add board_trace: trace board photos into a new KiCad project
    New KiCad 10 project (kicad/board_trace/) built by tracing the front/back board photos.
    - Front/back photos embedded as Reference Images (Dwgs.User / Cmts.User), dimmed (opacity 0.45) as a tracing background.
    - True scale 25.9375 px/mm (SFP 0.8mm pitch, VL813 9x9mm, USB-A 13.1mm) => board ~39.7 x 61.7 mm; images at scale 0.4554.
    - 43 footprints placed (no routing): 34 0603 passives (31 front / 3 back), U1 VL813 QFN-76 (back), J1/J2 USB3 HC-USB3.0-L175-2X1-P (C7501881), J3 SFP20P, Y1 25MHz crystal, L1 inductor, C50-C52 electrolytics.
    - USB3 connector footprint converted from EasyEDA (0.254 mm/unit).
    - Reproduce scripts under ki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
    [board_trace.kicad_pcb, board_trace.kicad_sch]
2026-09-12 Refine board_trace photo placement model and verification
    Fit J1/J2 to all 22 visible joints per bottom photo (RMS 0.075/0.072 mm, max 0.216/0.161 mm photo-fit error). Replace per-pad detections with manually reviewed component centers in scripts/04_review_plan.py and record retired references and rationale in placement_plan.json.
    Reclassify discovered parts: C52 -> J4 traced barrel jack, C32-C34 -> jack tabs, C51 -> radial through-hole electrolytic, C50 -> provisional D1, plus added MLCCs, R1-R11, L2/L3, U2 and D2/D3. All nonstandard footprints are now local with an fp-lib-table; board and footprint writes use the native pcbnew API only.
    Add scripts 04_review_plan.py, 05_overlay.py and 06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
    [board_trace.kicad_pcb]
2026-09-12 Add USB3-over-SFP+ electrical draft, evidence and receiver tooling
    New kicad/usb3_sfp_hub schematic draft: 105 components on six sheets covering the VL813 hub, SFP support/filter, hub power and clock, downstream port power, SFP regulated supply and USB3 signal ESD, with all ten hub USB2 pins and eight connector USB2 contacts deliberately isolated. Adds native local RPJ0009A, XGL4020 and DQA0010A footprints, mu metal and TI datasheets, an incomplete tracking BOM, and connectivity/budget/footprint check scripts. Reset supervisor U12 TPS3808G33DBVR replaces the RC; check_hub_reset.py and the port/SFP power budget checks pass their stated scope. ERC remains 7 errors/20 warnings and no PCB is cla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
    [TPS62902RPJ_TRANS.OLB, TPS62902_TRANS.dsn, TPS62902_TRANS.opj, bom.csv, connection_measurements.csv, hub_support.kicad_sch, murata_cap_characteristics.csv, nominal_typical_load_step.csv]
2026-09-13 Retire optical starting point; settle VL813/SFP+ vendor assets in usb3_sfp_hub
    Salvage the VL813 hub controller (LCSC C69418) and SFP+ 20-pin connector (C42418480) symbols, footprint and 3D models from the retired kicad/usb3_over_optical_hub project into kicad/usb3_sfp_hub/libs/lcsc/, matching the \/libs/lcsc/3dmodels paths the footprints already reference. Copies verified byte-identical (SHA-256); provenance recorded in provenance.json. Add the SFP+ connector footprint to the lcsc library. Update GOAL.md authoritative-artifacts row and remove kicad/usb3_over_optical_hub.
    No functional schematic change; the optical project was an unreferenced two-symbol starting point.
    [usb3_over_optical_hub.kicad_pcb, usb3_over_optical_hub.kicad_sch]
2026-09-13 board_trace: place CND-tek C5441174 SFP+ 1x1 cage, fit to connector J3
    Add C5441174 (MPN 201N1Y02001) cage footprint: 17 plated legs (7x 1.05 + 9x 0.95 + 1x 0.85 mm) on two rows 14.25 mm apart plus a 3-hole end row. Its land matches the board's 17 cage holes exactly.
    Place CAGE1 at (158.4663, 111.2747) rotation 0 - centred on J3 X, +12.0 mm toward the module end; connector J3 unchanged.
    Keep superseded C42931382 footprint (mis-labelled QSFP-derived import with 3 bogus pads) for history; add cage_fit.svg/pdf exports. Also commit pending 2026-09-13 HANDOFF.md and design/STATUS.md updates.
    [board_trace.kicad_pcb]
2026-09-13 chore: ignore board_trace backups directory
2026-09-13 usb3_sfp_hub: source JLCPCB parts; 3x3mm filter inductors and damping resistor
    L1/L2: replace the unavailable Coilcraft XGL4020-472MEC (LCSC stock 1) with cjiang FTC303018D4R7MBCA (LCSC C5832388), 3x3mm matching the calipered reference board, on Inductor_SMD:L_Changjiang_FTC303020D.
    R1/R2: replace the untraceable Panasonic ERJ8RQFR43V (no LCSC listing) with FH RTF06KR430FTG (LCSC C44453441), same 0.43 ohm 1% 1206 current-sense damping.
    - Assign LCSC/JLCPCB numbers to the settled passives and ICs; export to bom.csv.
    - Rebase check_sfp_power_budget on the real 72mOhm filter DCR and report the 0.10 ohm allocation gap instead of asserting it away.
    - Regenerate the six sheets, netlist, budget J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
    [bom.csv, hub_support.kicad_sch, port_power.kicad_sch, schematic_analysis.json, sfp_supply.kicad_sch, sfp_support.kicad_sch, usb3_esd.kicad_sch, usb3_sfp_hub.kicad_sch]
2026-09-13 usb3_sfp_hub: note GL3510-OSY52 as non-drop-in VL813 alternative
    Record Genesys Logic GL3510-OSY52 (LCSC C7501408) against U1 and in the README as a non-drop-in replacement for the EOL VL813: QFN-64 USB3.1 Gen1 4-port with built-in 5V->3.3V/1.2V regulators, different package/pinout, needs a new symbol/footprint and power/clock review.
    Regenerate the six sheets, netlist, BOM and previews.
    [bom.csv, usb3_sfp_hub.kicad_sch]
2026-09-13 board_trace: place XKB DC-005-2.5A-2.0 DC jack as J4; downsize C51
    Replace the provisional BarrelJack_PhotoTrace proxy with the real XKB
    DC-005-2.5A-2.0 panel-mount DC power jack (LCSC C319099). The footprint is
    transcribed from the vendor datasheet "PCB HOLES (TOP VIEW)" drawing and the
    EasyEDA package: three 3.0x0.8mm slots, the two collinear terminals 6.10mm apart
    and the break terminal 4.60mm to the side. Pin numbers follow the datasheet
    SCHEDULE (1 tip/centre, 2 break/switch, 3 outer/sleeve). J4 is placed on the two
    photo-measured collinear holes with the barrel facing the board edge; its break
    terminal lands within ~0.65mm of the old proxy's third joint.
    Downsize C51 from a D8.0mm to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
    [board_trace.kicad_pcb]
2026-09-13 board_trace: record KiCad layer-visibility change (pre-existing .prl edit)
